Silversmithe/motor-controller-modules/README.md

# motor-controller-modules

A repository to store all projects involving motor control modules, which can be used in various other projects.

## File Descriptor Language:
- rt: realtime
- hp: high-precision
