Silversmithe/motor-controller-modules/single_quad_rt_hp/hardware/README.md

Motor Controller Board
======================================

### Version B1 (HULA) v0.2

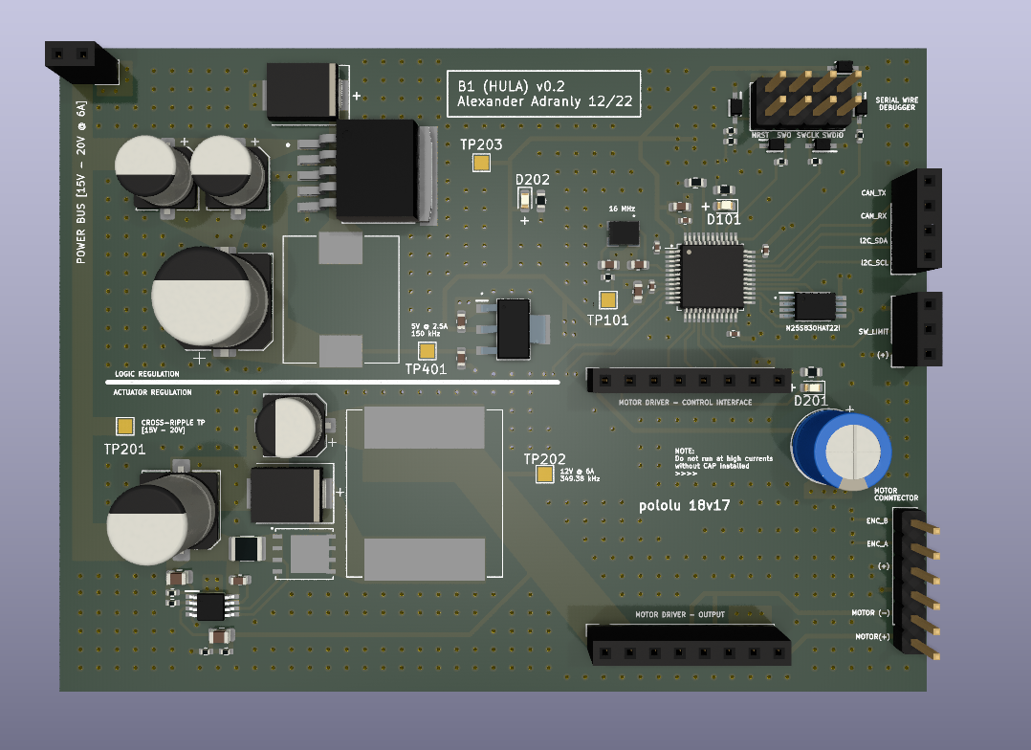
[picture p1: single_quad_rt_hp/hardware/images/motor_controller_v0_2.png]
B1 (HULA) v0.2
