Silversmithe/motor-controller-modules/single_quad_rt_hp/hardware/resources/lm2596-5_design.pdf

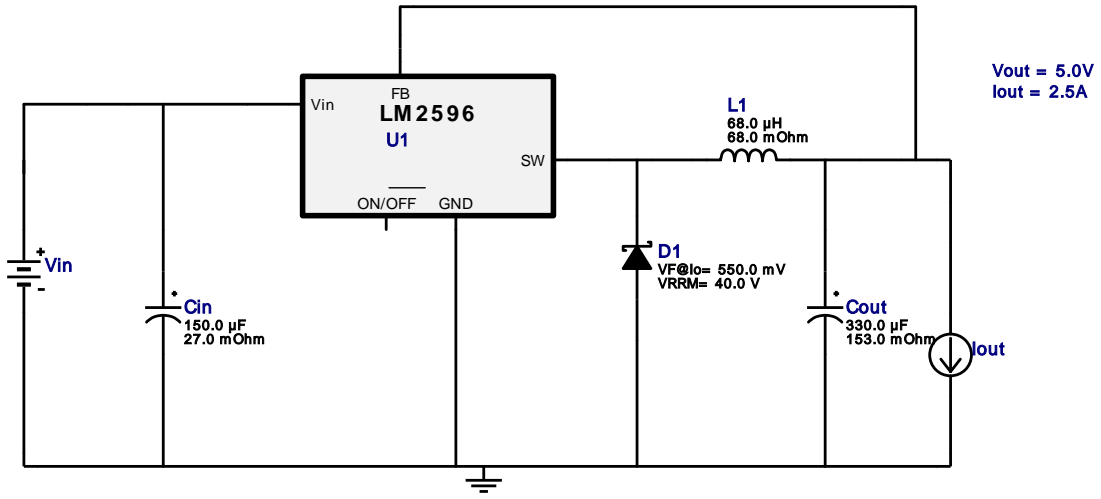
[picture p2: figure]
Cin 150.0 µF 27.0 m Ohm; Cout 330.0 µF 153.0 m Ohm; D1 VF@Io= 550.0 m V VRRM= 40.0 V; L1 68.0 µH 68.0 m Ohm; LM 2 5 9 6 Vin; ON/OFF; GND; Vout = 5.0V Iout = 2.5A; Vin; Iout

Copyright © 2022, Texas Instruments Incorporated | 1 | ti.com/webench

WEBENCH®
Design Report LM2596SX-5.0/NOPB : LM2596SX-5.0/ NOPB 15V-20V to 5.00V @ 2.5A November 18, 2022 22:43:04 GMT-06:00

## WEBENCH ® Design Report

Design : 3 LM2596SX-5.0/NOPB
LM2596SX-5.0/NOPB 15V-20V to 5.00V @ 2.5A

VinMin = 15.0V
VinMax = 20.0V
Vout = 5.0V
Iout = 2.5A

Device = LM2596SX-5.0/NOPB Topology = Buck
Created = 2022-11-18 22:30:03.629 BOM Cost = $6.35
BOM Count = 6
Total Pd = 2.56W

## Electrical BOM

Name | Manufacturer | Part Number | Properties | Qty Price | Footprint
Cf | Samsung Electro- Mechanics | CL21C332JBFNNNE (http://www.samsungsem.com/servlet/FileDownload?type%3Dspec%26file%3DCL21C332JBFNNNE.pdf) Series= C0G/NP0 | Cap= 3.3 nF VDC= 50.0 V IRMS= 0.0 A
1 | $0.04
| | | | | 0805 7 mm²
Cin | Panasonic | EEHZA1V151P Series= ZA | Cap= 150.0 uF ESR= 27.0 mOhm VDC= 35.0 V IRMS= 2.3 A
1 | $1.31

SM_RADIAL_8MM 113 mm²
Cout | Panasonic | EEV-FK2A331M (http://www.panasonic.com/industrial/components/pdf/smt%5Faec%5F050505.pdf) Series= FK

Cap= 330.0 uF
ESR= 153.0 mOhm
VDC= 100.0 V
IRMS= 917.0 mA

1 $1.60

SM_RADIAL_K16 483 mm²
D1 | Diodes Inc. | B540C-13-F (http://www.diodes.com/datasheets/ds13012.pdf) | VF@Io= 550.0 mV VRRM= 40.0 V
1 | $0.19

SMC 83 mm²
L1 | Coilcraft | MSS1210-683MEB (http://www.coilcraft.com/pdfs/mss1210.pdf) | L= 68.0 µH 68.0 mOhm
1 | $0.81

MSS1210 204 mm²

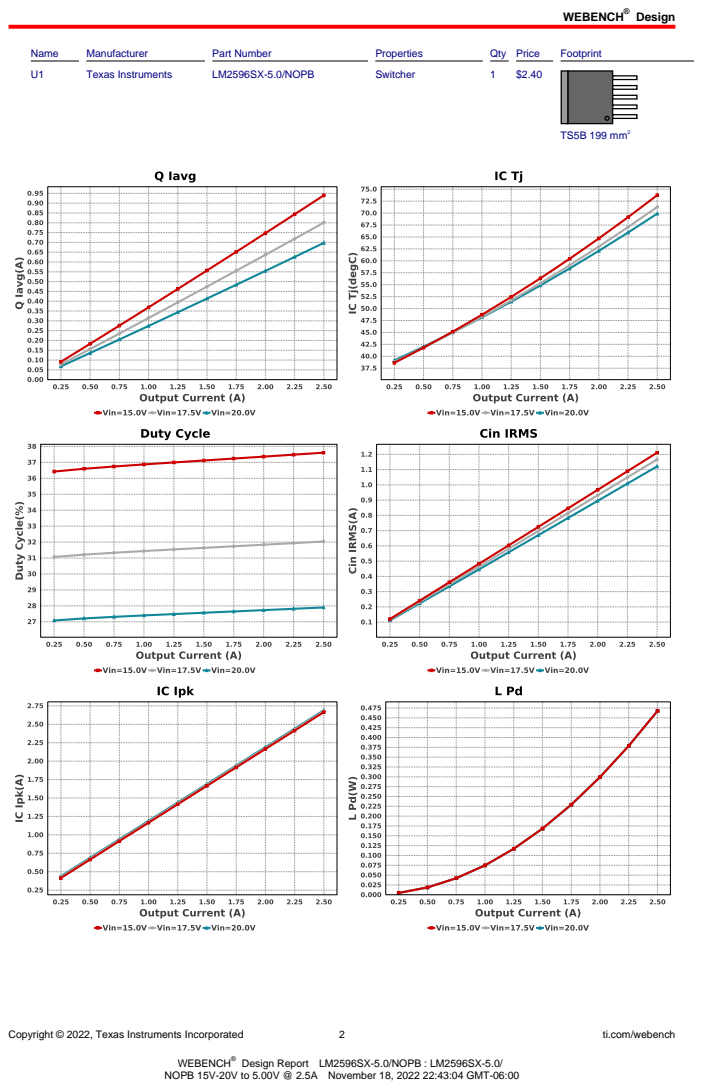
[picture p3: page 2]
Design; Copyright © 2022, Texas Instruments Incorporated; ti.com/webench; Name; Manufacturer; Part Number; Properties; Qty Price; Footprint; Texas Instruments; LM2596SX-5.0/NOPB; Switcher; TS5B 199 mm²

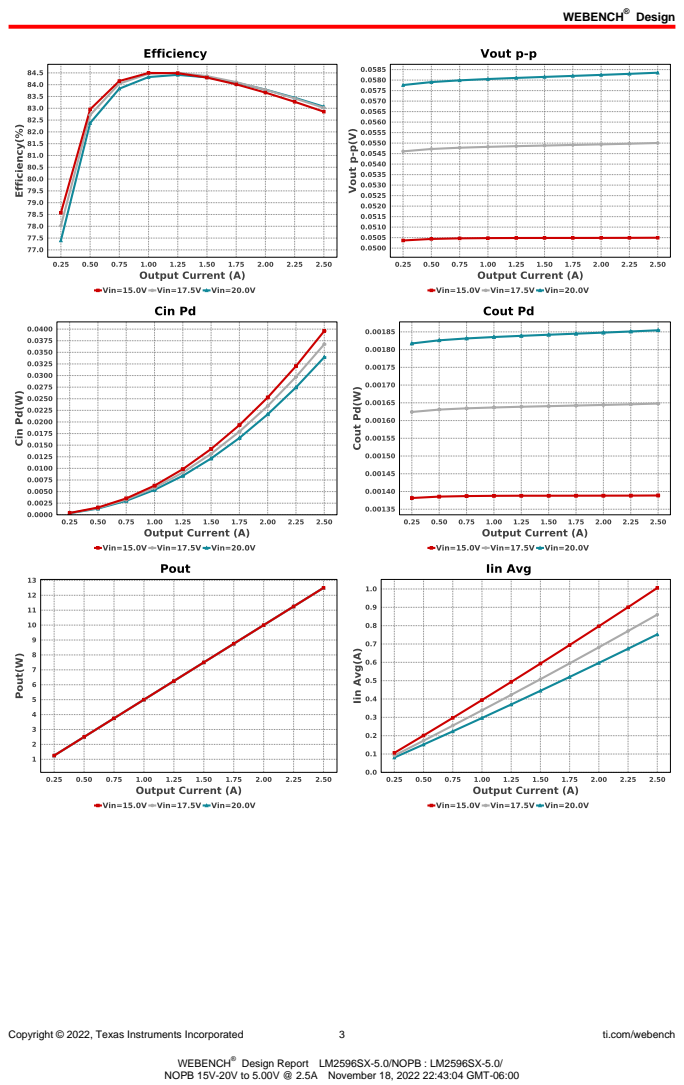
[picture p4: page 3]
Copyright © 2022, Texas Instruments Incorporated; ti.com/webench

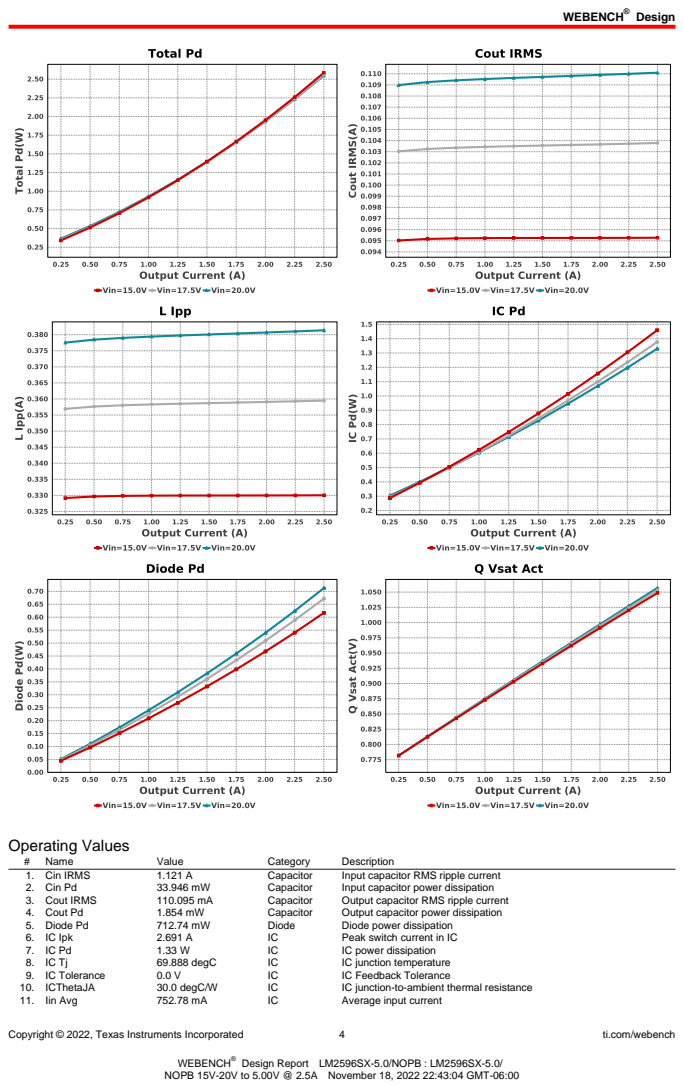
[picture p5: page 4]
Copyright © 2022, Texas Instruments Incorporated; ti.com/webench; Operating Values; Name; Value; Category; Description; 1. Cin IRMS; Capacitor; Input capacitor RMS ripple current; 2. Cin Pd; Input capacitor power dissipation; 3. Cout IRMS; Output capacitor RMS ripple current; 4. Cout Pd; Output capacitor power dissipation; 5. Diode Pd; Diode; Diode power dissipation; 6. IC Ipk; Peak switch current in IC; IC power dissipation; 69.888 degC; IC junction temperature; 9. IC Tolerance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

Copyright © 2022, Texas Instruments Incorporated | 5 | ti.com/webench
# | Name | Value | Category | Description

12. L Ipp | 381.38 mA | Inductor | Peak-to-peak inductor ripple current
13. L Pd | 467.5 mW | Inductor | Inductor power dissipation
14. Q Iavg | 697.501 mA | Mosfet | Q Iavg
15. Cin Pd | 33.946 mW | Power | Input capacitor power dissipation
16. Cout Pd | 1.854 mW | Power | Output capacitor power dissipation
17. Diode Pd | 712.74 mW | Power | Diode power dissipation
18. IC Pd | 1.33 W | Power | IC power dissipation
19. L Pd | 467.5 mW | Power | Inductor power dissipation
20. Total Pd | 2.556 W | Power | Total Power Dissipation
21. BOM Count | 6 | System
| | | Information | Total Design BOM count
22. Duty Cycle | 27.9 % | System
| | | Information | Duty cycle
23. Efficiency | 83.025 % | System
| | | Information | Steady state efficiency
24. FootPrint | 1.09 k mm² | System
| | | Information | Total Foot Print Area of BOM components
25. Frequency | 150.0 kHz | System
| | | Information | Switching frequency
26. Iout | 2.5 A | System
| | | Information | Iout operating point
27. Mode | CCM | System
| | | Information | Conduction Mode
28. Pout | 12.5 W | System
| | | Information | Total output power
29. Total BOM | $6.35 | System
| | | Information | Total BOM Cost
30. Vin | 20.0 V | System
| | | Information | Vin operating point
31. Vout p-p | 58.351 mV | System
| | | Information | Peak-to-peak output ripple voltage
32. Q Vsat Act | 1.057 V | Transistor | Q Vsat

## Design Inputs

Name | Value | Description
Iout | 2.5 | Maximum Output Current
VinMax | 20.0 | Maximum input voltage
VinMin | 15.0 | Minimum input voltage
Vout | 5.0 | Output Voltage
| base_pn | | LM2596 | Base Product Number
source | DC | Input Source Type
Ta | 30.0 | Ambient temperature


Copyright © 2022, Texas Instruments Incorporated | 6 | ti.com/webench

## Assembly

## Component Testing

Some published data on components in datasheets such as Capacitor ESR and Inductor DC resistance is based on conservative values that will guarantee that the components always exceed the specification. For design purposes it is usually better to work with typical values. Since this data is not always available it is a good practice to measure the Capacitance and ESR values of Cin and Cout, and the inductance and DC resistance of L1 before assembly of the board. Any large discrepancies in values should be electrically simulated in WEBENCH to check for instabilities and thermally simulated in WebTHERM to make sure critical temperatures are not exceeded.

## Soldering Component to Board

If board assembly is done in house it is best to tack down one terminal of a component on the board then solder the other terminal. For surface mount parts with large tabs, such as the DPAK, the tab on the back of the package should be pre-tinned with solder, then tacked into place by one of the pins. To solder the tab town to the board place the iron down on the board while resting against the tab, heating both surfaces simultaneously. Apply light pressure to the top of the plastic case until the solder flows around the part and the part is flush with the PCB. If the solder is not flowing around the board you may need a higher wattage iron (generally 25W to 30W is enough).

## Initial Startup of Circuit

It is best to initially power up the board by setting the input supply voltage to the lowest operating input voltage 15.0V and set the input supply's current limit to zero. With the input supply off connect up the input supply to Vin and GND. Connect a digital volt meter and a load if needed to set the minimum Iout of the design from Vout and GND. Turn on the input supply and slowly turn up the current limit on the input supply.
If the voltage starts to rise on the input supply continue increasing the input supply current limit while watching the output voltage. If the current increases on the input supply, but the voltage remains near zero, then there may be a short or a component misplaced on the board. Power down the board and visually inspect for solder bridges and recheck the diode and capacitor polarities. Once the power supply circuit is operational then more extensive testing may include full load testing, transient load and line tests to compare with simulation results.

## Load Testing

The setup is the same as the initial startup, except that an additional digital voltmeter is connected between Vin and GND, a load is connected between Vout and GND and a current meter is connected in series between Vout and the load. The load must be able to handle at least rated output power + 50% ( 7.5 watts for this design). Ideally the load is supplied in the form of a variable load test unit. It can also be done in the form of suitably large power resistors. When using an oscilloscope to measure waveforms on the prototype board, the ground leads of the oscilloscope probes should be as short as possible and the area of the loop formed by the ground lead should be kept to a minimum. This will help reduce ground lead inductance and eliminate EMI noise that is not actually present in the circuit.

## Design Assistance

1. Master key : 554E87F380B10EF862A869D8392B4870[v1]
2. LM2596 Product Folder : http://www.ti.com/product/LM2596 : contains the data sheet and other resources.

Copyright © 2022, Texas Instruments Incorporated | 7 | ti.com/webench

Important Notice and Disclaimer

TI provides technical and reliability data (including datasheets), design resources (including reference designs), application or other design advice, web tools, safety information, and other resources AS IS and with all faults, and disclaims all warranties. These resources are intended for skilled developers designing with TI products. You are solely responsible for (1) selecting the appropriate TI products for your application, (2) designing, validating and testing your application, and (3) ensuring your application meets applicable standards, and any other safety, security, or other requirements.

These resources are subject to change without notice. TI grants you permission to use these resources only for development of an application that uses the TI products described in the resource. Other reproduction and display of these resources is prohibited. No license is granted to any other TI intellectual property right or to any third party intellectual property right. TI disclaims responsibility for, and you will fully indemnify TI and its representatives against, any claims, damages, costs, losses, and liabilities arising out of your use of these resources.

Providing these resources does not expand or otherwise alter TI's applicable Terms of Sale or other applicable terms available either on ti.com or provided in conjunction with TI products.
