Silversmithe/motor-controller-modules/single_quad_rt_hp/hardware/images/motor_controller_v0_1.png

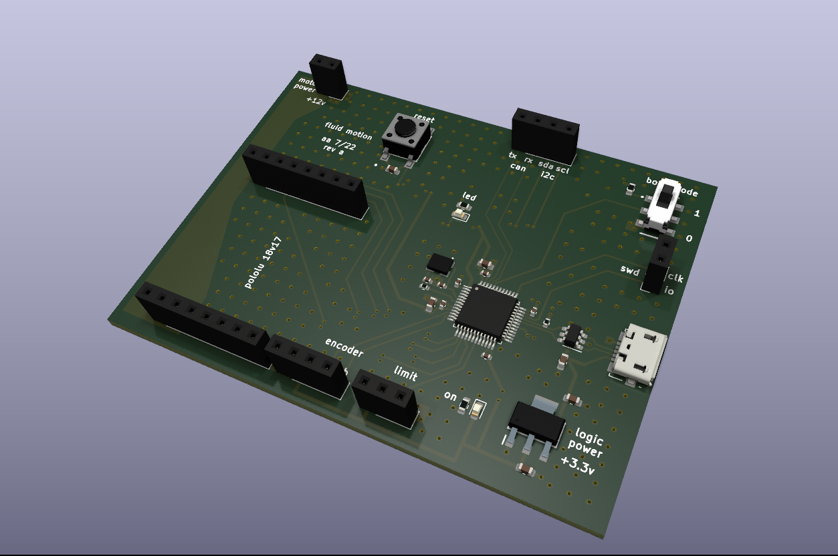
single_quad_rt_hp/hardware/images/motor_controller_v0_1.png
