Silversmithe/motor-controller-modules/single_quad_rt_hp/hardware/testing.xlsx

Sheet: v0.1
No. | Features |  | Does it work? | Hardware Hacking Required? | Notes
1 | Power Regulation
1.1 |  | 3.3V Regluator (Logic) | Y | N | Powered through power supply / USB, and in both scenarios the power LED turns on. The microcontroller can also sucessfully execute code.
1.2 |  | 12V Regulated Input (Actuator) | N/A | N | These are just female headers
2 | Microcontroller (STM32F302)
2.1 |  | Bypass Capacitors | Y | N | Manually checked all capacitors with a probe to ensure they all are carrying 3.3V
2.2 |  | HSE Clock | N | N/A | CPU Hardware Guide - Section 2.1 HSERDY flag in RCC_CR Flag determines if the clock is stable, and this must be set at startup. Check this flag to confirm if HSE is actually working correctly.
2.3 |  | Serial Wire Debug | Y | Y | Successfully can program the micro with STLINK. Had to use pins from other parts of the board to get STLINK to work correctly. PRINTF does NOT work! Notes: provide all necessary pins for STLINK (MCU VDD, GND, NRST, SWCLK, SWDIO). Provide SWO in order to be able to use tracing & printf
2.4 |  | Reset Button | Y | N | Notes: attach this to SWD in the second iteration of this board. Or maybe do both?
2.5 |  | BOOT0 Switch Select | N | N | Wired incorrectly, signal is unable to be pulled high. Pull-down resistor is incorrectly placed. Notes: Potentially just keep BOOT0 pulled low, because we don’t need to program via USB. Can potentially remove this circuit.
3 | Communication (COM)
3.1 |  | Universal Serial Bus (USB) 2.0 | N | N/A | USB Delivers power, but actual communication to the host computer has not been possible yet Notes: remove in the next generation, with SWD USB may just be unecessary
3.2 |  | Controller Area Network (CAN) | N/A | N/A
3.3 |  | I2C | Y | N/A | Hooked up to an arduino (master). Very easy to set up.
4 | Status Signals (STAT)
4.1 |  | Power LED | Y | N | Turns on when power is supplied to the board & light is bright.
4.2 |  | Status LED (LED_STAT) | Y | N | Turns on when pin set high by microcontroller
5 | Control/Feedback Signals (CTRL)
5.1 |  | Limit Switch (SW_LIMIT) | Y | N | Works as expected. Wired button with resistor to the limit switch to test.
5.2 |  | Motor - Direction | Y | Y | Notes: Incorrectly routed
5.3 |  | Motor - Speed (PWM) | Y | Y | Notes: Incorrectly routed
5.4 |  | Motor - Sleep | Y | Y | Notes: Incorrectly routed
5.5 |  | Motor - Fault | Y | Y | Notes: Incorrectly routed
5.6 |  | Encoders A & B | Y | N/A | Counts up to 400 ticks from one full rotation. 6.25 (gear ratio) * 64 (ticks per shaft revolution) = 400 ticks. Verify that clock does not revert to internal version for complete success. Notes:

Sheet: v0.2
No. | Features |  | Does it work? | Hardware Hacking Required? | Notes
1 | Power Regulation
1.1 |  | 3.3V Regulator Logic | N | N/A | [15V - 20V] -> 5V (Switching Regulator) -> 3.3V (Linear Regulator) - switching regulator outputs only 0.4V, likely an issue with component selection
1.2 |  | 12V Regulator Actuator | N | N/A | [15V - 20V] -> 12V (Switching Regulator) - smokes at input capacitor, potentially a short. Sparks when trying to power using BUS test point. - this regulator is excessive, we can just remove this and rely on the power supply for the entire robot
2 | Microcontroller (STM32F302)
2.1 |  | Bypass Capacitors | N/A | N/A | Manually checked all capacitors with a probe to ensure they all are carrying 3.3V
2.2 |  | HSE Clock | N/A | N/A | CPU Hardware Guide - Section 2.1 HSERDY flag in RCC_CR Flag determines if the clock is stable, and this must be set at startup. Check this flag to confirm if HSE is actually working correctly.
2.3 |  | Serial Wire Debug | N/A | N/A
2.4 |  | BOOT0 Select | N/A | N/A
3 | Peripherals
3.1 |  | SRAM | N/A | N/A
4 | Communication (COM)
4.1 |  | Controller Area Network (CAN) | N/A | N/A
4.2 |  | I2C | N/A | N/A
5 | Status Signals (STAT)
5.1 |  | Logic Power LED | N/A | N/A
5.2 |  | Actuator Power LED | N/A | N/A
5.3 |  | LED STAT | N/A | N/A
6 | Control/Feedback Signals (CTRL)
6.1 |  | Limit Switch (SW_LIMIT) | N/A | N/A
6.2 |  | Motor - Direction | N/A | N/A
6.3 |  | Motor - Speed (PWM) | N/A | N/A
6.4 |  | Motor - Sleep | N/A | N/A
6.5 |  | Motor - Fault | N/A | N/A
6.6 |  | Encoders A & B | N/A | N/A
