Silversmithe/motor-controller-modules/single_quad_rt_hp/hardware/versions/motor_controller-v0_1/motor_controller_schematic.pdf

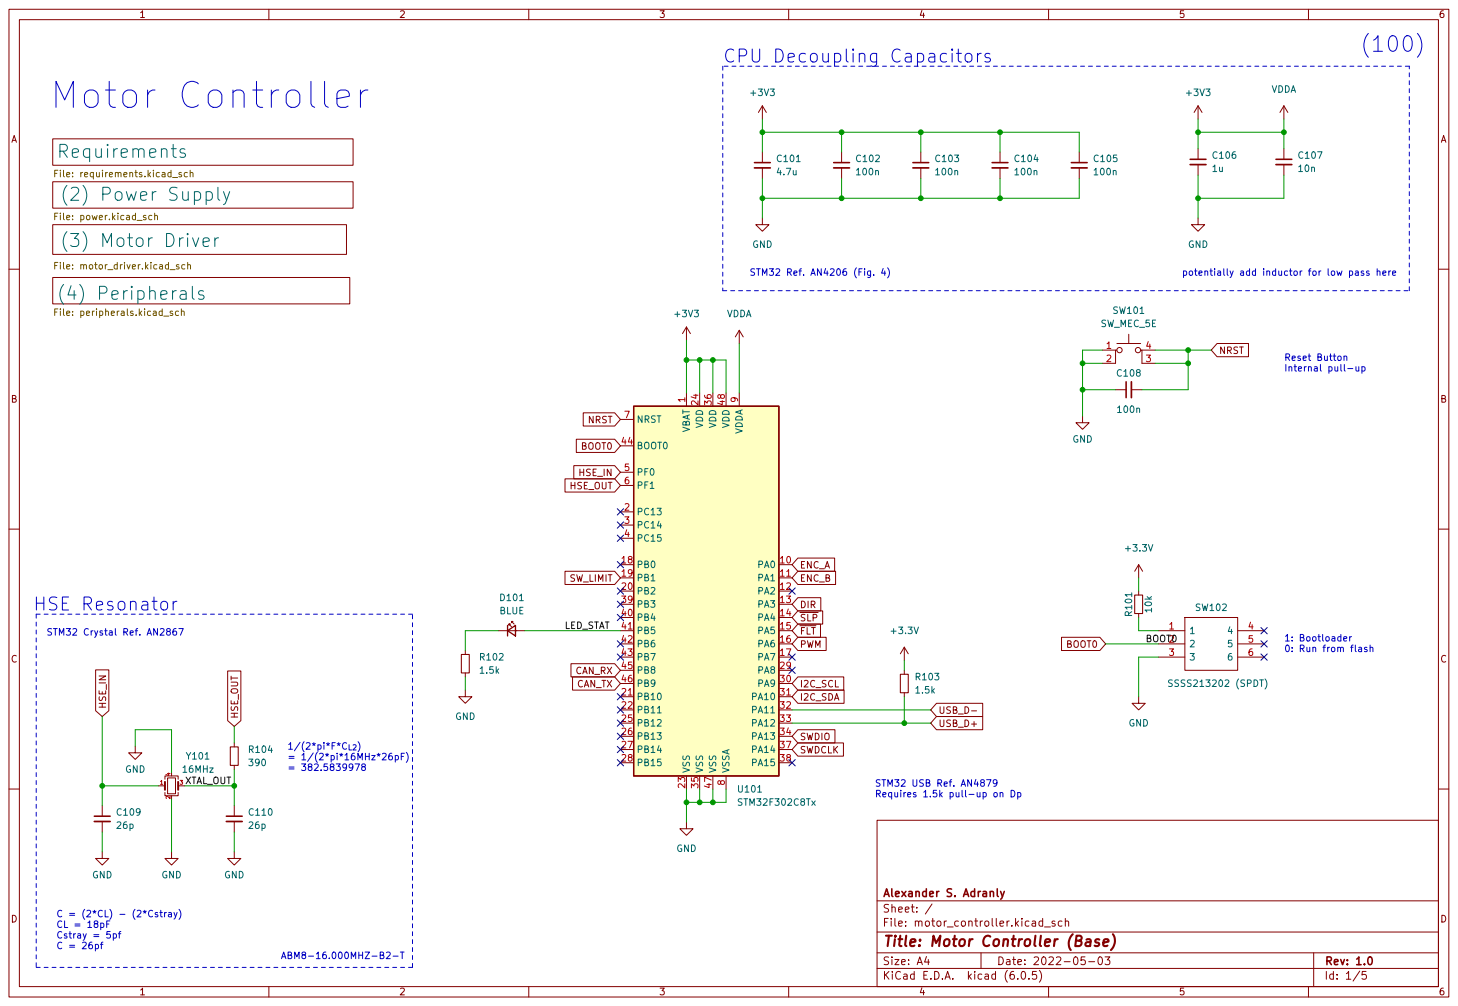
[picture p8: page 1]

1 PA0 10 PA1 11 PA2 12 PA3 13 PA4 14 PA5 15 PA6 16 PA7 17 PB0 18 PB1 19 PC13 2 PB2 20 PB10 21 PB11 22 VSS 23 VDD 24 PB12 25 PB13 26 PB14 27 PB15 28 PA8 29 PC14 3 PA9 30 PA10 31 PA11 32 PA12 33 PA13 34 VSS 35 VDD 36 PA14 37 PA15 38 PB3 39 PC15 4 PB4 40 PB5 41 PB6 42 PB7 43 BOOT0 44 PB8 45 PB9 46 VSS 47 VDD 48 PF0 5 PF1 6 NRST 7 VSSA

File: motor_controller.kicad_sch Sheet: / Alexander S. Adranly

Id: 1/5 Title: Motor Controller (Base)

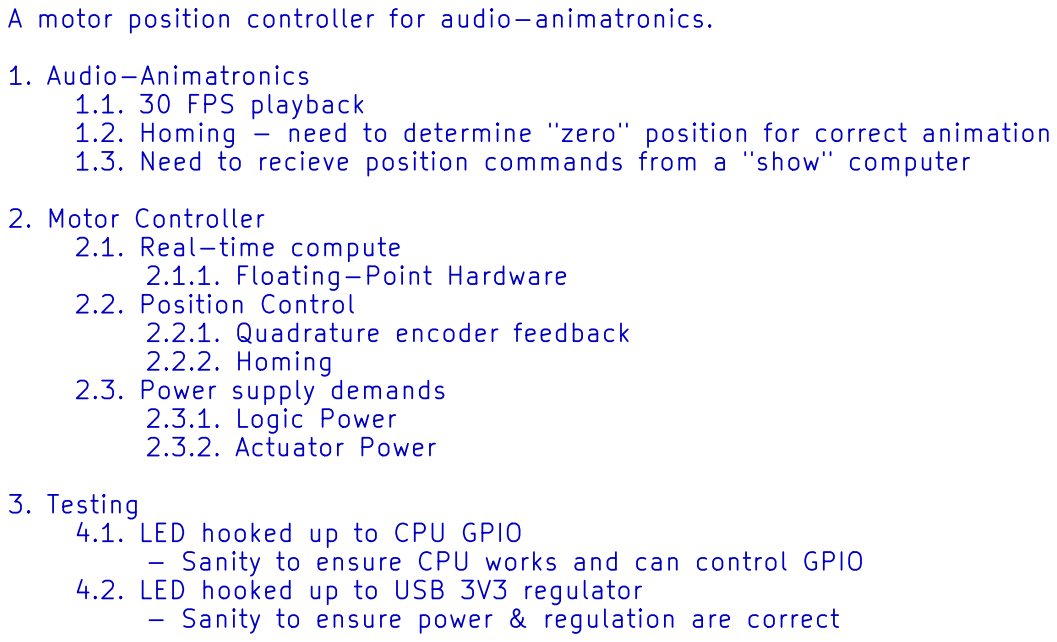
[picture p9: page 2]

A motor position controller for audio-animatronics. 1. Audio-Animatronics

1.1. 30 FPS playback
1.2. Homing - need to determine "zero" position for correct animation
1.3. Need to recieve position commands from a "show" computer 2. Motor Controller

2.1. Real-time compute
2.1.1. Floating-Point Hardware
2.2. Position Control 2.2.1. Quadrature encoder feedback

3. Testing
4.1. LED hooked up to CPU GPIO
- Sanity to ensure CPU works and can control GPIO
4.2. LED hooked up to USB 3V3 regulator
- Sanity to ensure power & regulation are correct

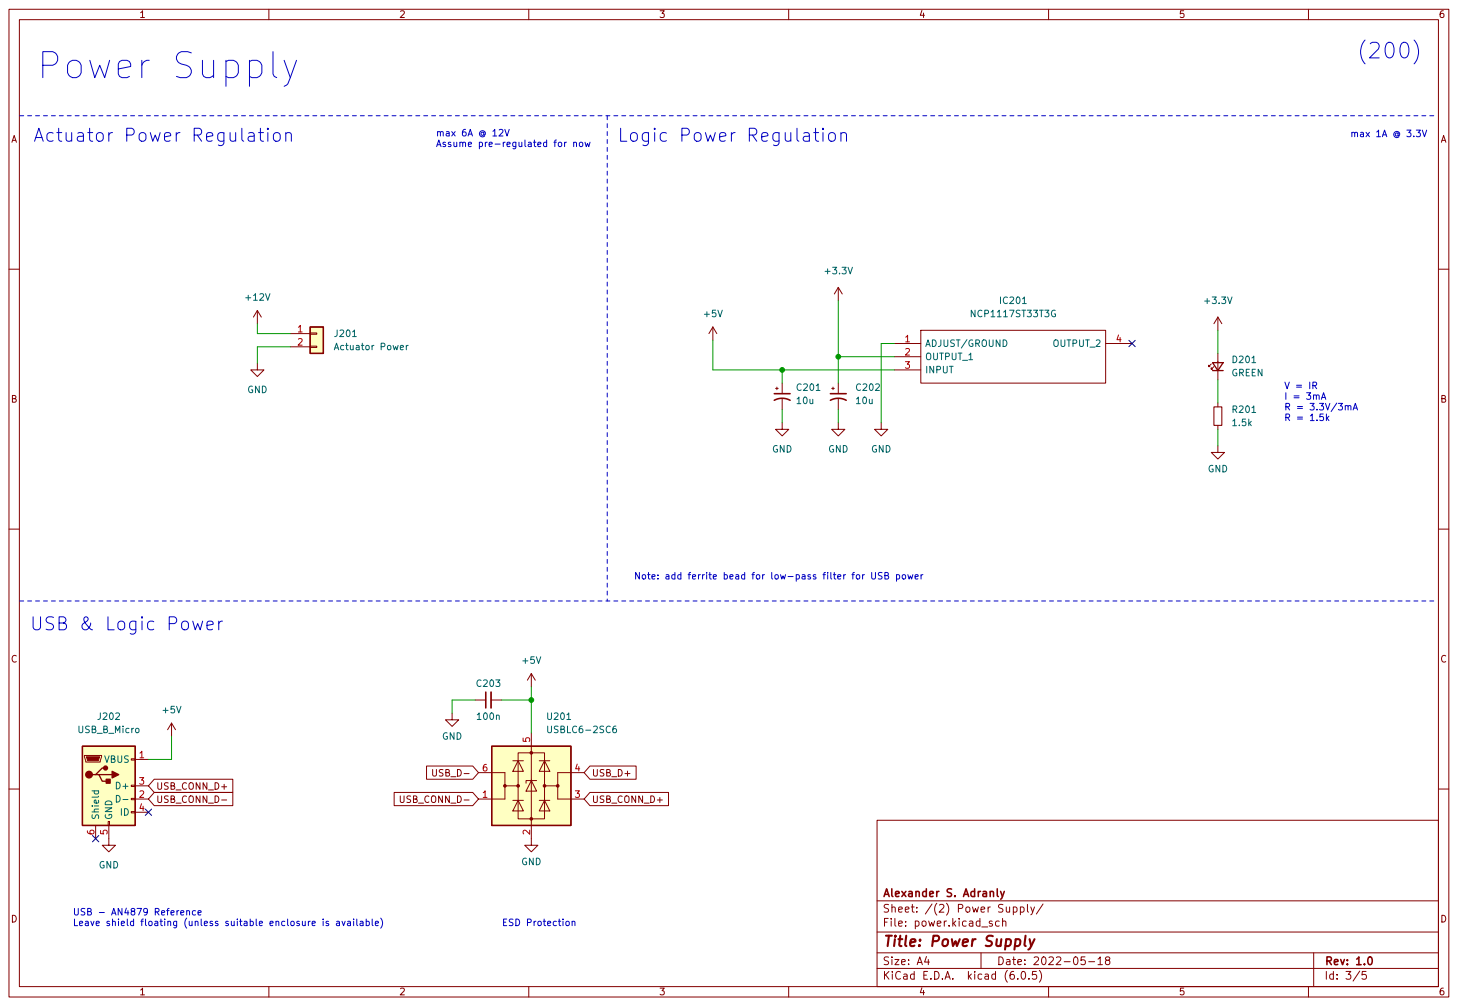
[picture p10: page 3]

(200) max 1A @ 3.3V USB & Logic Power USB - AN4879 Reference
Power Supply

max 6A @ 12V
Assume pre-regulated for now

Sheet: /(2) Power Supply/
File: power.kicad_sch
Id: 3/5 Title: Power Supply

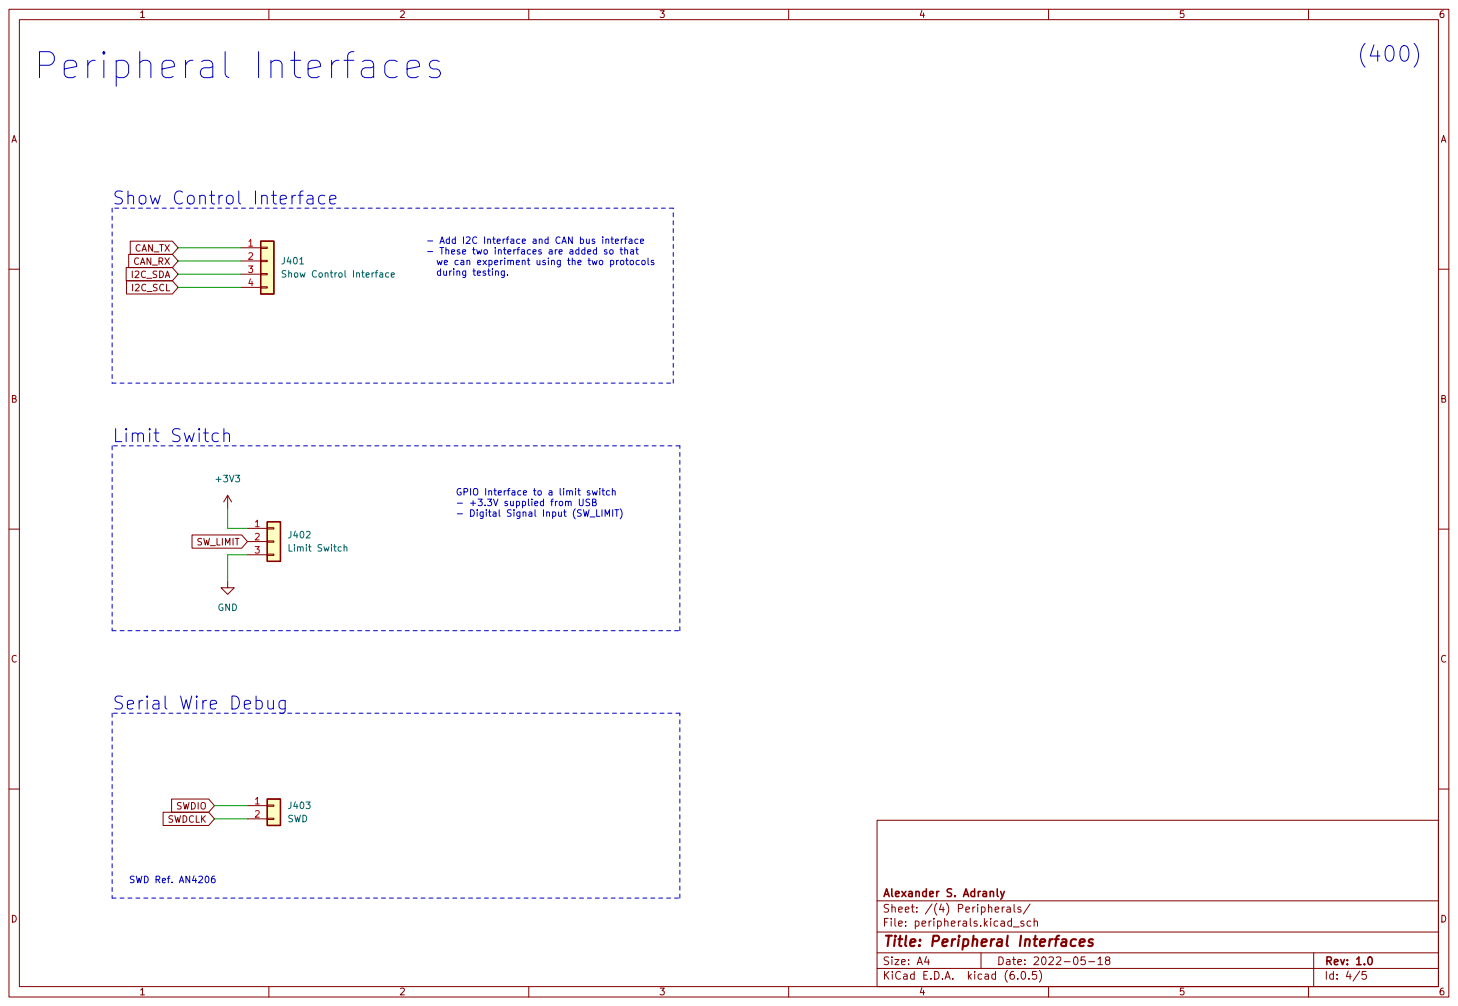
[picture p11: page 4]

- Add I2C Interface and CAN bus interface
- These two interfaces are added so that
we can experiment using the two protocols
during testing.

GPIO Interface to a limit switch
- +3.3V supplied from USB
- Digital Signal Input (SW_LIMIT)

Alexander S. Adranly
Sheet: /(4) Peripherals/
File: peripherals.kicad_sch
Id: 4/5 Title: Peripheral Interfaces

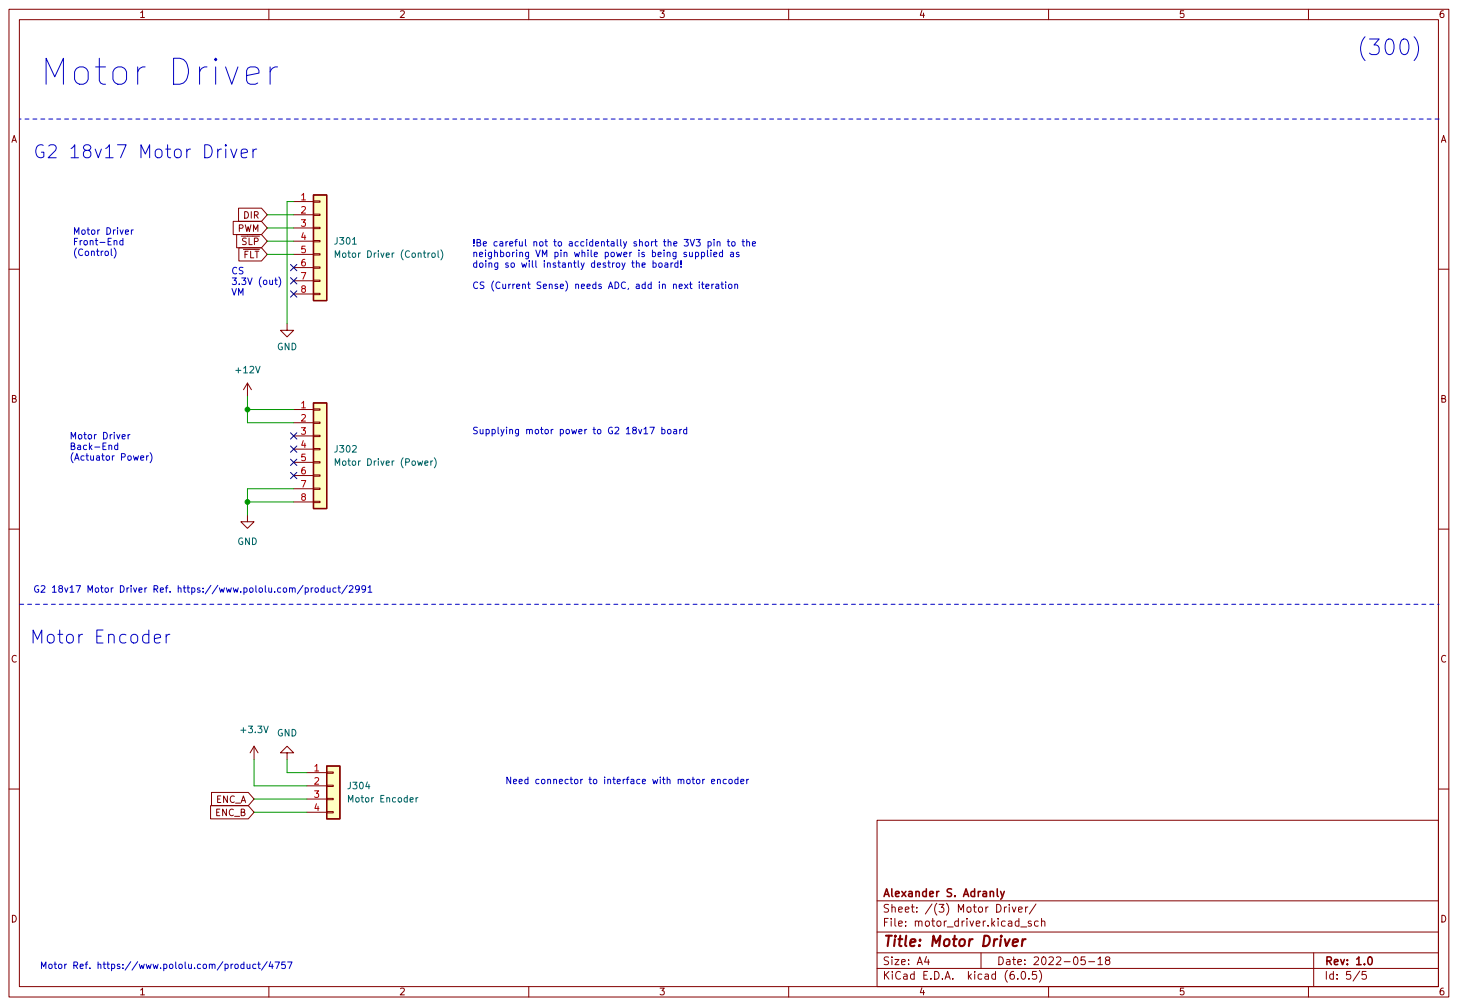
[picture p12: page 5]

Motor Driver Front-End (Control)

!Be careful not to accidentally short the 3V3 pin to the
neighboring VM pin while power is being supplied as
doing so will instantly destroy the board!

CS (Current Sense) needs ADC, add in next iteration

G2 18v17 Motor Driver Ref. https://www.pololu.com/product/2991 Motor Driver Back-End (Actuator Power)

Alexander S. Adranly
Sheet: /(3) Motor Driver/
File: motor_driver.kicad_sch
Id: 5/5 Title: Motor Driver

Motor Ref. https://www.pololu.com/product/4757
