Silversmithe/motor-controller-modules/single_quad_rt_hp/hardware/versions/motor_controller-v0_1/motor_controller_pcb.pdf

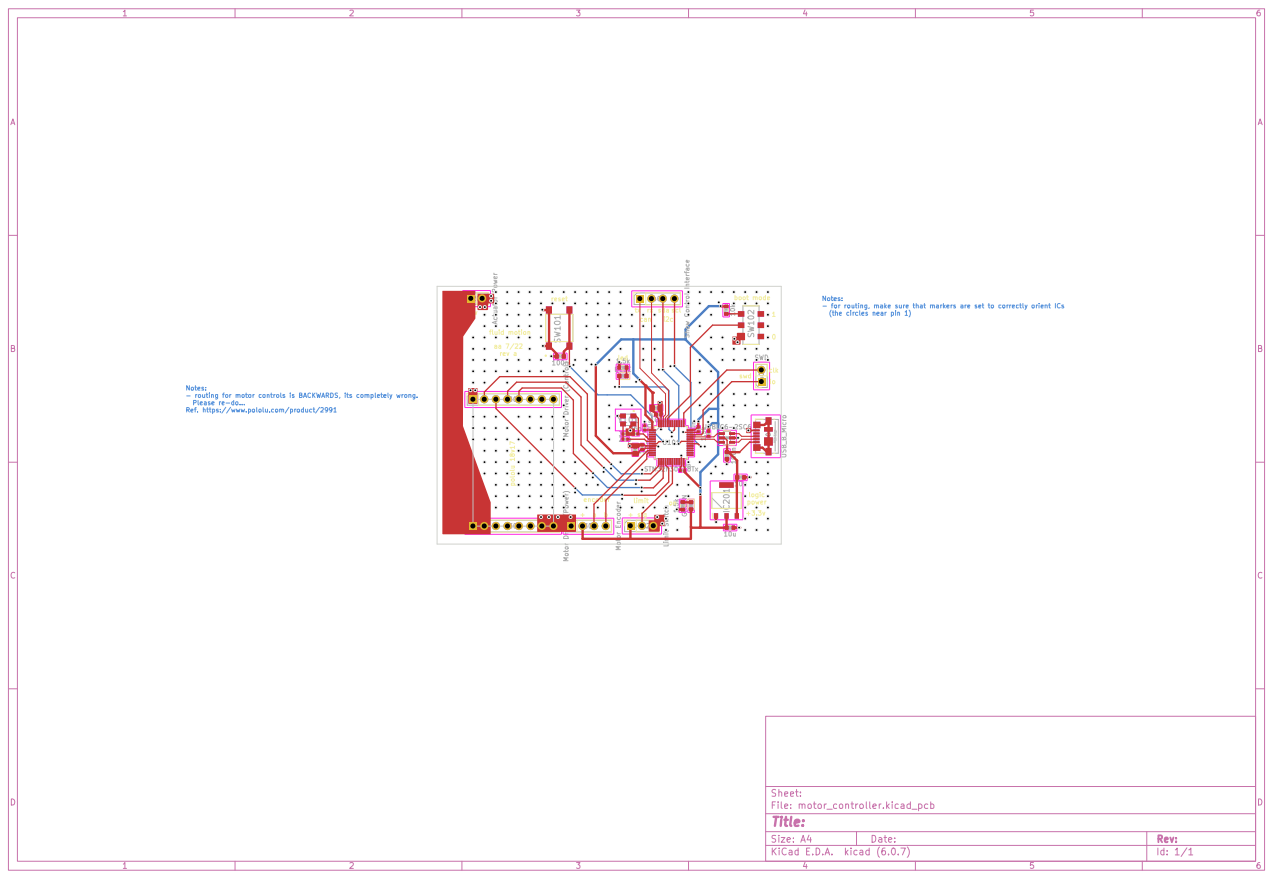
[picture p18: page 1]
