Silversmithe/motor-controller-modules/single_quad_rt_hp/hardware/motor_controller/actuator_regulator.kicad_sch

## KiCad design single_quad_rt_hp/hardware/motor_controller/actuator_regulator.kicad_sch (2023-01-30)

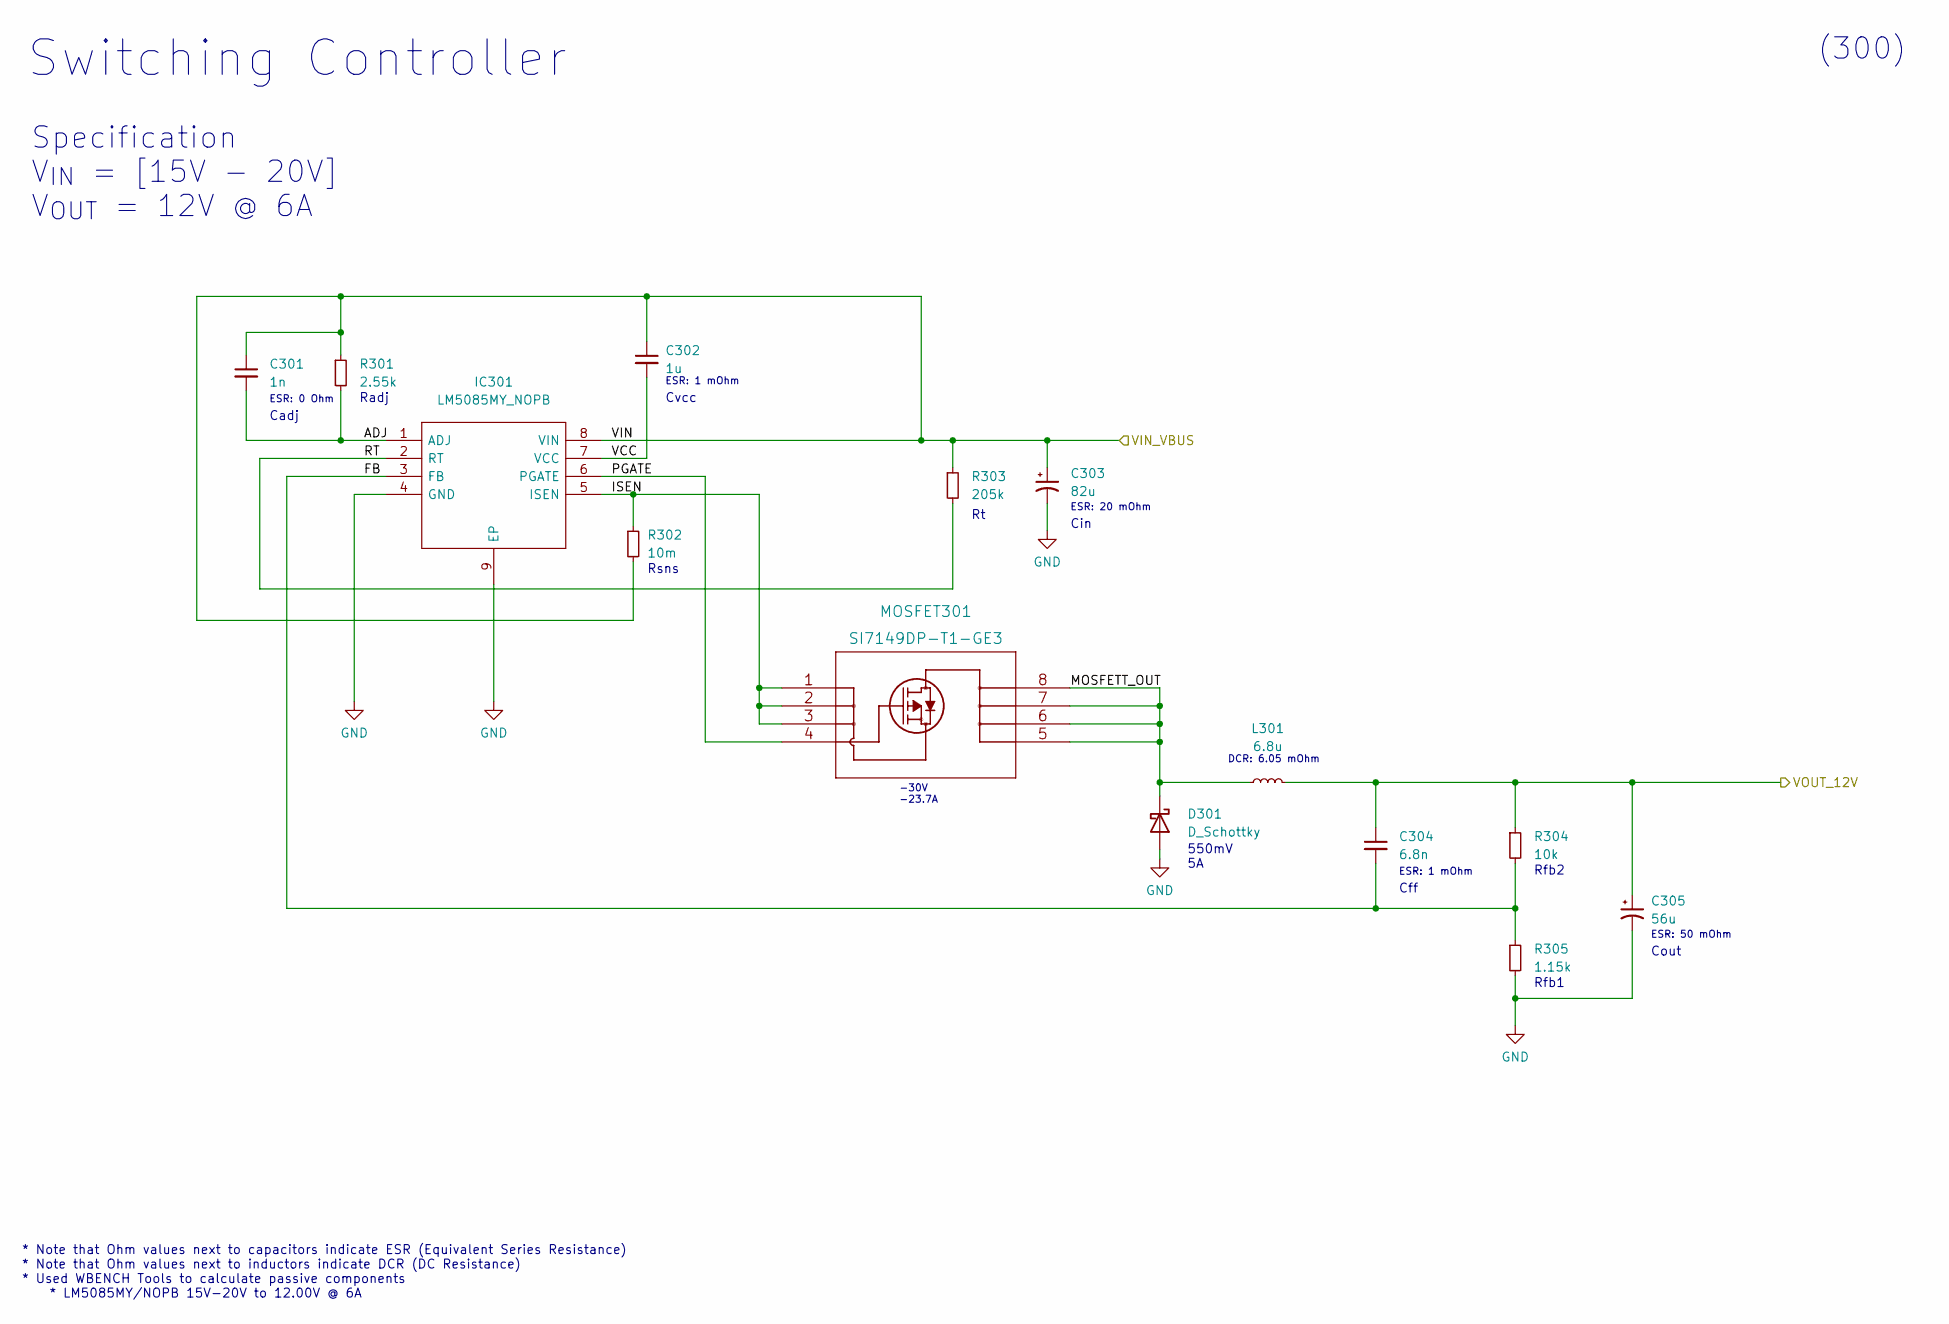
[picture p19: schematic actuator_regulator.kicad_sch]

Parts:
C301: 1n; C_0805_2012Metric; Manufacturer_Part_Number CL21C102JBCNNNC
C302: 1u; C_0603_1608Metric; Manufacturer_Part_Number EMK107B7105KA-T
C303: 82u; CP_Elec_8x11.9; Manufacturer_Part_Number 35SVPF82M
C304: 6.8n; C_0805_2012Metric; Manufacturer_Part_Number GRM2195C1H682JA01D
C305: 56u; CP_Elec_6.3x5.8; Manufacturer_Part_Number EEHZC1E560P
D301: D_Schottky; D_SMC; Manufacturer_Part_Number B540C-13-F
IC301: LM5085MY_NOPB; SOP65P490X109-9N; Mouser Part Number 926-LM5085MY/NOPB
L301: 6.8u; YSPIA1770-6R8M; Manufacturer_Part_Number YSPIA1770-6R8M
MOSFET301: SI7149DP-T1-GE3; Manufacturer_Part_Number SI7149DP-T1-GE3
R301: 2.55k; R_0402_1005Metric; Manufacturer_Part_Number TC0250B2551TCC
R302: 10m; R_1210_3225Metric; Manufacturer_Part_Number 1210W2F100MT5E
R303: 205k; R_0402_1005Metric; Manufacturer_Part_Number AC0402FR-07205KL
R304: 10k; R_0402_1005Metric; Manufacturer_Part_Number 0402WGF1002TCE
R305: 1.15k; R_0402_1005Metric; Manufacturer_Part_Number RTT021151FTH

Connections:
ADJ: C301.2, IC301.1 (ADJ), R301.2
FB: C304.2, IC301.3 (FB), R304.2, R305.1
GND: C303.2, C305.2, D301.2 (A), IC301.4 (GND), IC301.9 (EP), R305.2
ISEN: IC301.5 (ISEN), MOSFET301.1, MOSFET301.2, MOSFET301.3, R302.1
MOSFETT_OUT: D301.1 (K), L301.1, MOSFET301.5, MOSFET301.6, MOSFET301.7, MOSFET301.8
PGATE: IC301.6 (PGATE), MOSFET301.4
RT: IC301.2 (RT), R303.2
VCC: C302.2, IC301.7 (VCC)
VIN: C301.1, C302.1, C303.1, IC301.8 (VIN), R301.1, R302.2, R303.1
VOUT_12V: C304.1, C305.1, L301.2, R304.1

Notes on the sheet:
DCR: 6.05 mOhm
Rfb1
Cin
Rsns
-30V -23.7A
Cadj
Rfb2
ESR: 20 mOhm
ESR: 0 Ohm
(300)
Specification V_{IN} = [15V - 20V] V_{OUT} = 12V @ 6A
Cff
Radj
Cvcc
* Note that Ohm values next to capacitors indicate ESR (Equivalent Series Resistance) * Note that Ohm values next to inductors indicate DCR (DC Resistance) * Used WBENCH Tools to calculate passive components * LM5085MY/NOPB 15V-20V to 12.00V @ 6A
ESR: 50 mOhm
ESR: 1 mOhm
Cout
Switching Controller
550mV 5A
