Silversmithe/motor-controller-modules/single_quad_rt_hp/hardware/motor_controller/bus_regulator.kicad_sch

## KiCad design single_quad_rt_hp/hardware/motor_controller/bus_regulator.kicad_sch (2023-01-30)

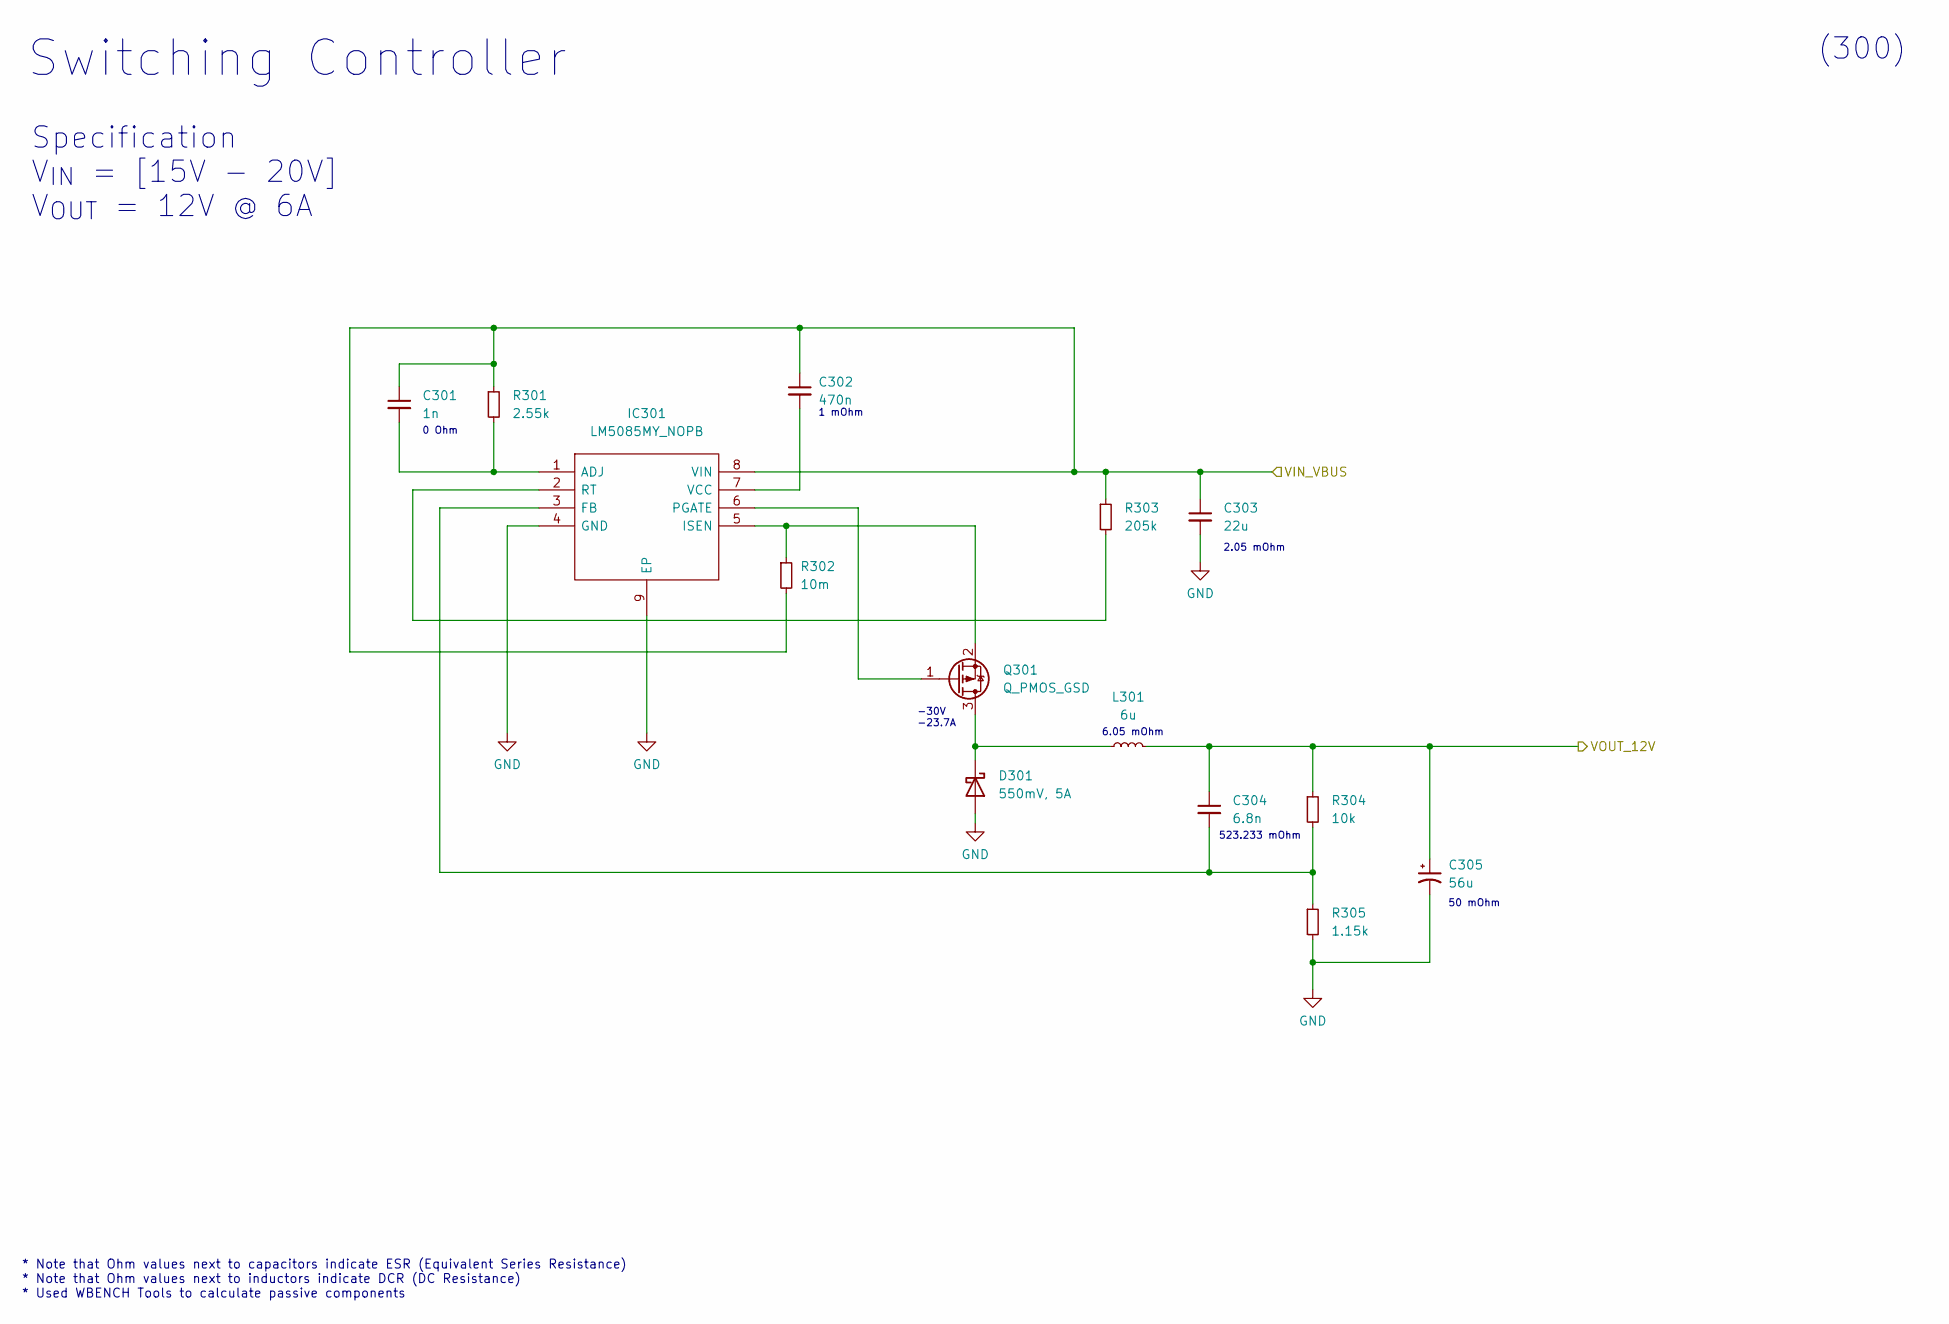
[picture p20: schematic bus_regulator.kicad_sch]

Parts:
C301: 1n
C302: 470n
C303: 22u
C304: 6.8n
C305: 56u
D301: 550mV, 5A
IC301: LM5085MY_NOPB; SOP65P490X109-9N; Mouser Part Number 926-LM5085MY/NOPB
L301: 6u
Q301: Q_PMOS_GSD
R301: 2.55k
R302: 10m
R303: 205k
R304: 10k
R305: 1.15k

Connections:
GND: C303.2, C305.2, D301.2 (A), IC301.4 (GND), IC301.9 (EP), R305.2
unnamed: C301.2, IC301.1 (ADJ), R301.2
unnamed: C302.2, IC301.7 (VCC)
unnamed: C304.2, IC301.3 (FB), R304.2, R305.1
unnamed: D301.1 (K), L301.1, Q301.3 (D)
unnamed: IC301.2 (RT), R303.2
unnamed: IC301.5 (ISEN), Q301.2 (S), R302.1
unnamed: IC301.6 (PGATE), Q301.1 (G)
VIN_VBUS: C301.1, C302.1, C303.1, IC301.8 (VIN), R301.1, R302.2, R303.1
VOUT_12V: C304.1, C305.1, L301.2, R304.1

Notes on the sheet:
6.05 mOhm
-30V -23.7A
2.05 mOhm
0 Ohm
(300)
Specification V_{IN} = [15V - 20V] V_{OUT} = 12V @ 6A
* Note that Ohm values next to capacitors indicate ESR (Equivalent Series Resistance) * Note that Ohm values next to inductors indicate DCR (DC Resistance) * Used WBENCH Tools to calculate passive components
50 mOhm
1 mOhm
523.233 mOhm
Switching Controller
