Silversmithe/motor-controller-modules/single_quad_rt_hp/hardware/motor_controller/logic_regulator.kicad_sch

## KiCad design single_quad_rt_hp/hardware/motor_controller/logic_regulator.kicad_sch (2023-04-17)

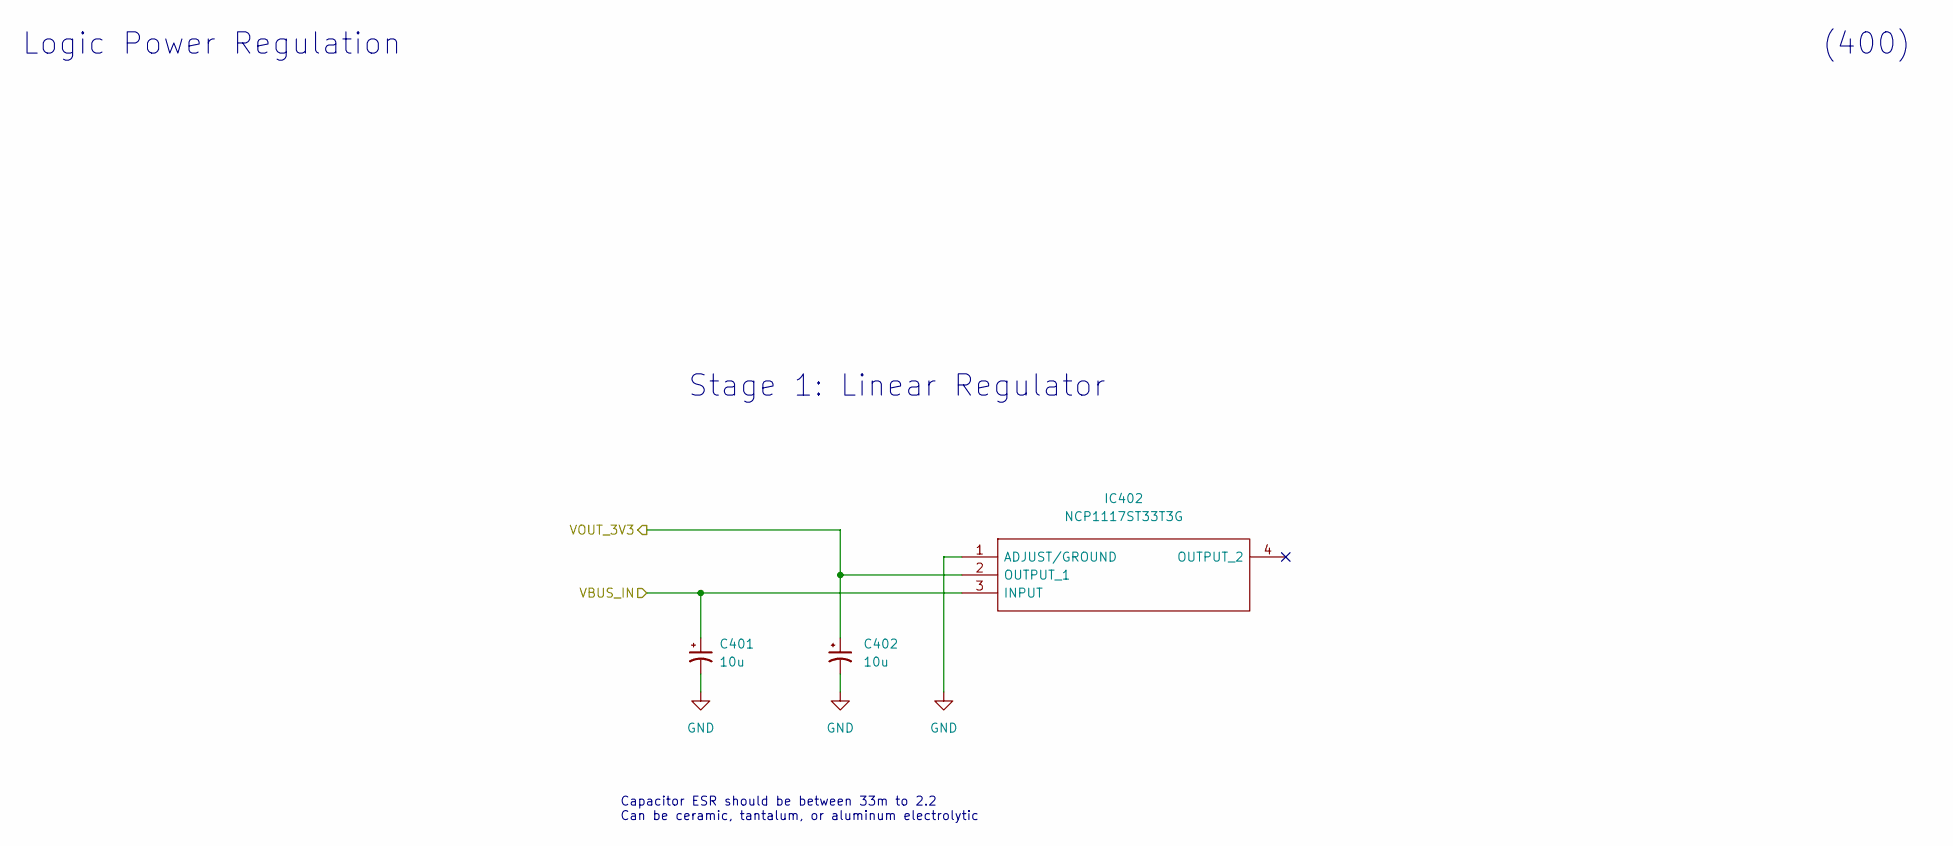
[picture p21: schematic logic_regulator.kicad_sch]

Parts:
C401, C402: 10u; C_0603_1608Metric; Manufacturer_Part_Number CL10A106KP8NNNC
IC402: NCP1117ST33T3G; SOT230P700X180-4N; Mouser Part Number 863-NCP1117ST33T3G

Connections:
GND: C401.2, C402.2, IC402.1 (ADJUST/GROUND)
VBUS_IN: C401.1, IC402.3 (INPUT)
VOUT_3V3: C402.1, IC402.2 (OUTPUT_1)

Notes on the sheet:
(400)
Stage 1: Linear Regulator
Capacitor ESR should be between 33m to 2.2 Can be ceramic, tantalum, or aluminum electrolytic
Logic Power Regulation
