Silversmithe/motor-controller-modules/single_quad_rt_hp/hardware/motor_controller/motor_controller.kicad_sch

## KiCad design single_quad_rt_hp/hardware/motor_controller/motor_controller.kicad_sch (2023-04-17)

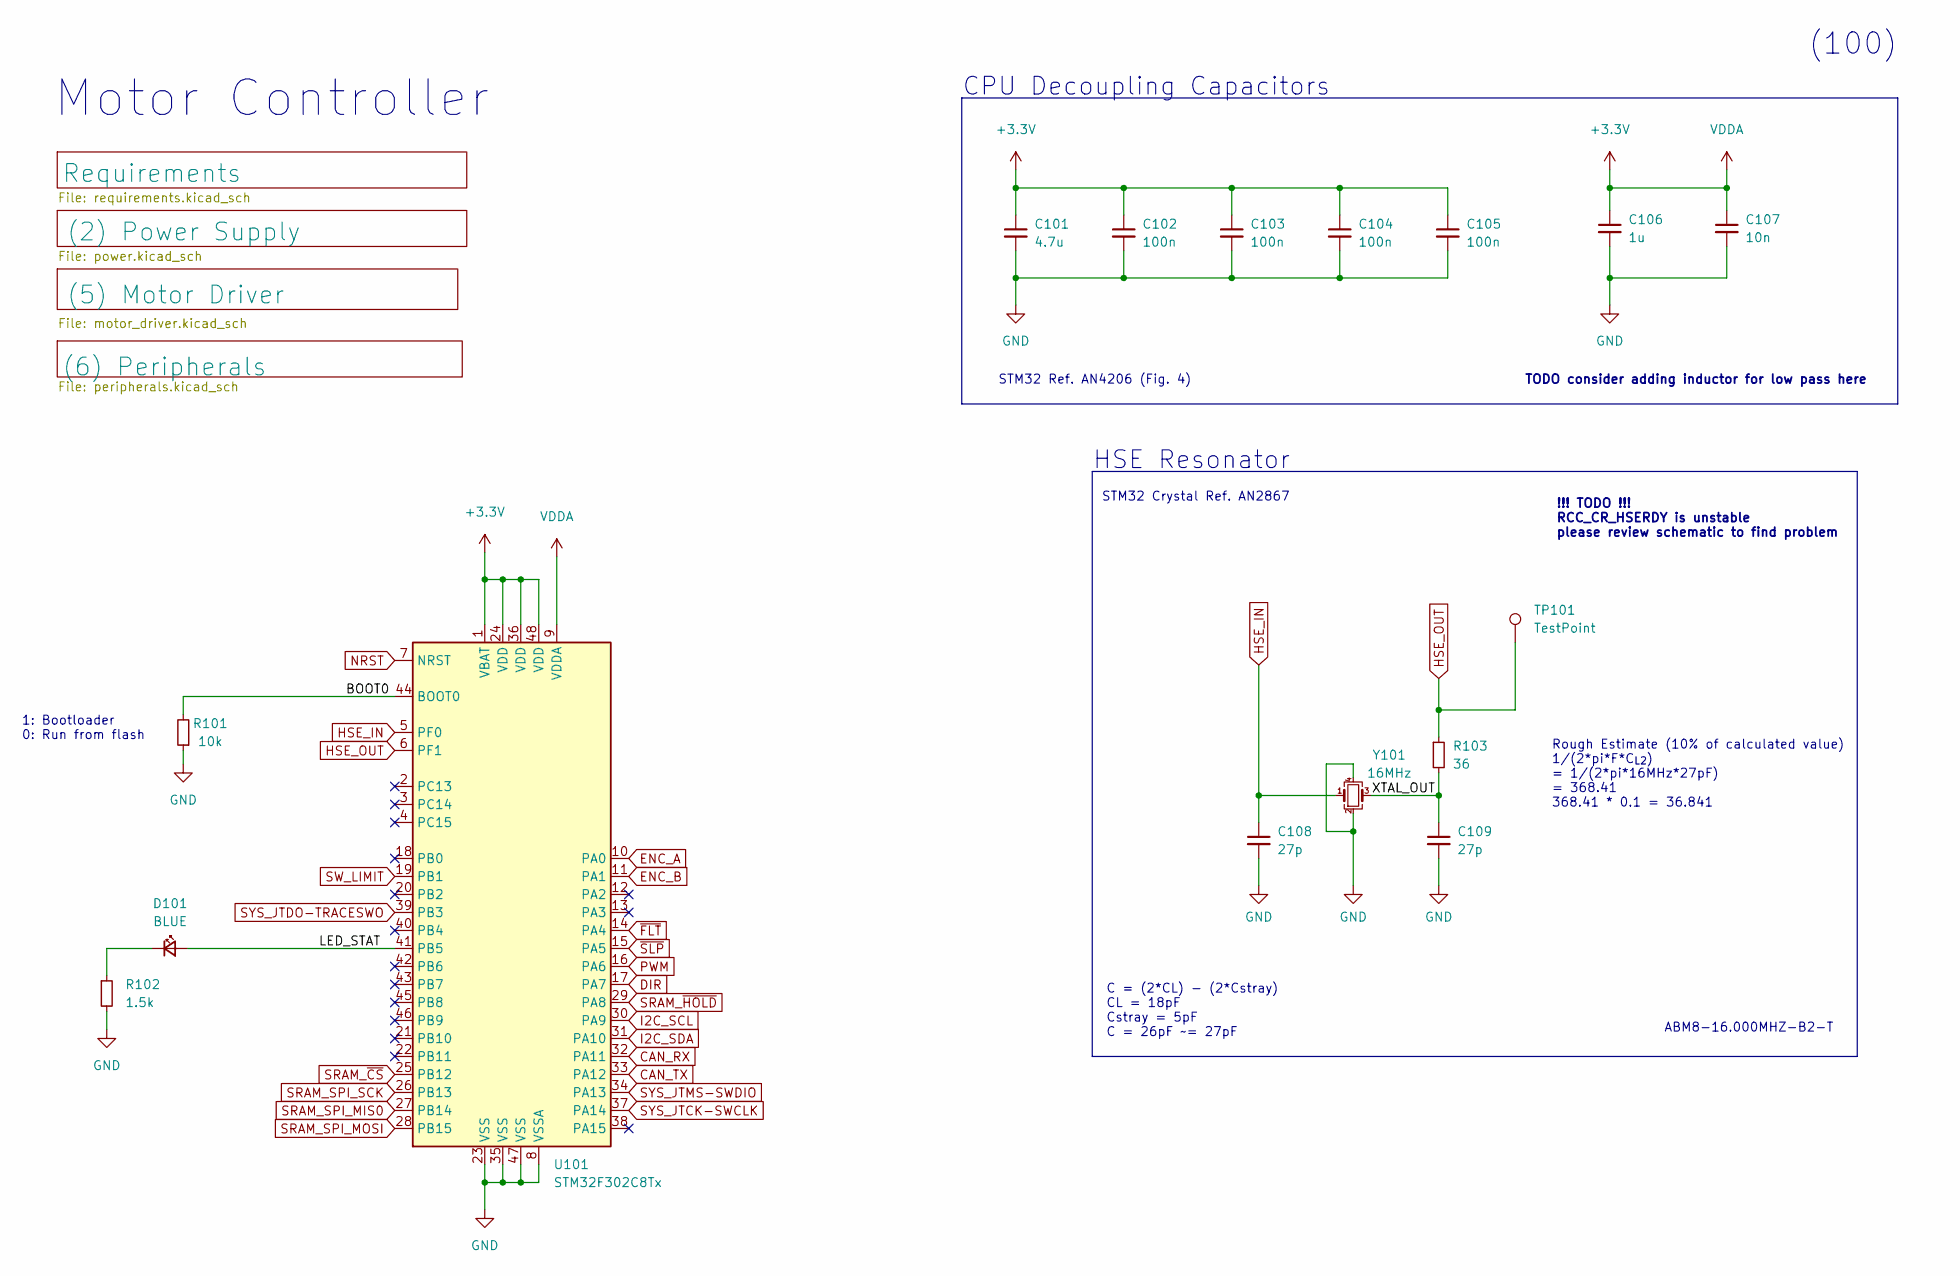
[picture p22: schematic motor_controller.kicad_sch]

Parts:
C101: 4.7u; C_0603_1608Metric; Manufacturer_Part_Number CL10A475KO8NNNC
C102, C103, C104, C105: 100n; C_0402_1005Metric; Manufacturer_Part_Number CL05B104KB54PNC
C106: 1u; C_0603_1608Metric; Manufacturer_Part_Number CL10A105KB8NNNC
C107: 10n; C_0402_1005Metric; Manufacturer_Part_Number CL05B103KB5NNNC
C108, C109: 27p; C_0603_1608Metric; Manufacturer_Part_Number GRM1885C1H270FA01D
D101: BLUE; LED_0603_1608Metric; Manufacturer_Part_Number 19-217/BHC-ZL1M2RY/3T
R101: 10k; R_0603_1608Metric; Manufacturer_Part_Number 0603WAF1002T5E
R102: 1.5k; R_0603_1608Metric; Manufacturer_Part_Number 0603WAF1501T5E
R103: 36; R_0402_1005Metric; Manufacturer_Part_Number RTT0236R0FTH
TP101: TestPoint; TestPoint_Pad_1.5x1.5mm
U101: STM32F302C8Tx; LQFP-48_7x7mm_P0.5mm; Manufacturer_Part_Number STM32F302C8T6
Y101: 16MHz; ABM816000MHZB2T; Manufacturer_Part_Number ABM8-16.000MHZ-B2-T

Connections:
+3.3V: C101.1, C102.1, C103.1, C104.1, C105.1, C106.1, C107.1, U101.1 (VBAT), U101.9 (VDDA), U101.24 (VDD), U101.36 (VDD), U101.48 (VDD)
BOOT0: R101.2, U101.44 (BOOT0)
CAN_RX: U101.32 (PA11)
CAN_TX: U101.33 (PA12)
DIR: U101.17 (PA7)
ENC_A: U101.10 (PA0)
ENC_B: U101.11 (PA1)
GND: C101.2, C102.2, C103.2, C104.2, C105.2, C106.2, C107.2, C108.2, C109.2, R101.1, R102.2, U101.8 (VSSA), U101.23 (VSS), U101.35 (VSS), U101.47 (VSS), Y101.2, Y101.4
HSE_IN: C108.1, U101.5 (PF0), Y101.1
HSE_OUT: R103.1, TP101.1, U101.6 (PF1)
I2C_SCL: U101.30 (PA9)
I2C_SDA: U101.31 (PA10)
LED_STAT: D101.2 (A), U101.41 (PB5)
NRST: U101.7 (NRST)
unnamed: D101.1 (K), R102.1
PWM: U101.16 (PA6)
SRAM_SPI_MIS0: U101.27 (PB14)
SRAM_SPI_MOSI: U101.28 (PB15)
SRAM_SPI_SCK: U101.26 (PB13)
SRAM_~CS: U101.25 (PB12)
SRAM_~HOLD: U101.29 (PA8)
SW_LIMIT: U101.19 (PB1)
SYS_JTCK-SWCLK: U101.37 (PA14)
SYS_JTDO-TRACESWO: U101.39 (PB3)
SYS_JTMS-SWDIO: U101.34 (PA13)
XTAL_OUT: C109.1, R103.2, Y101.3
~FLT: U101.14 (PA4)
~SLP: U101.15 (PA5)

Notes on the sheet:
Motor Controller
Rough Estimate (10% of calculated value) 1/(2*pi*F*C_{L2}) = 1/(2*pi*16MHz*27pF) = 368.41 368.41 * 0.1 = 36.841
1: Bootloader 0: Run from flash
!!! TODO !!! RCC_CR_HSERDY is unstable please review schematic to find problem
HSE Resonator
TODO consider adding inductor for low pass here
CPU Decoupling Capacitors
STM32 Ref. AN4206 (Fig. 4)
STM32 Crystal Ref. AN2867
(100)
C = (2*CL) - (2*Cstray) CL = 18pF Cstray = 5pF C = 26pF ~= 27pF
ABM8-16.000MHZ-B2-T
