Silversmithe/motor-controller-modules/single_quad_rt_hp/hardware/motor_controller/motor_driver.kicad_sch

## KiCad design single_quad_rt_hp/hardware/motor_controller/motor_driver.kicad_sch (2023-04-17)

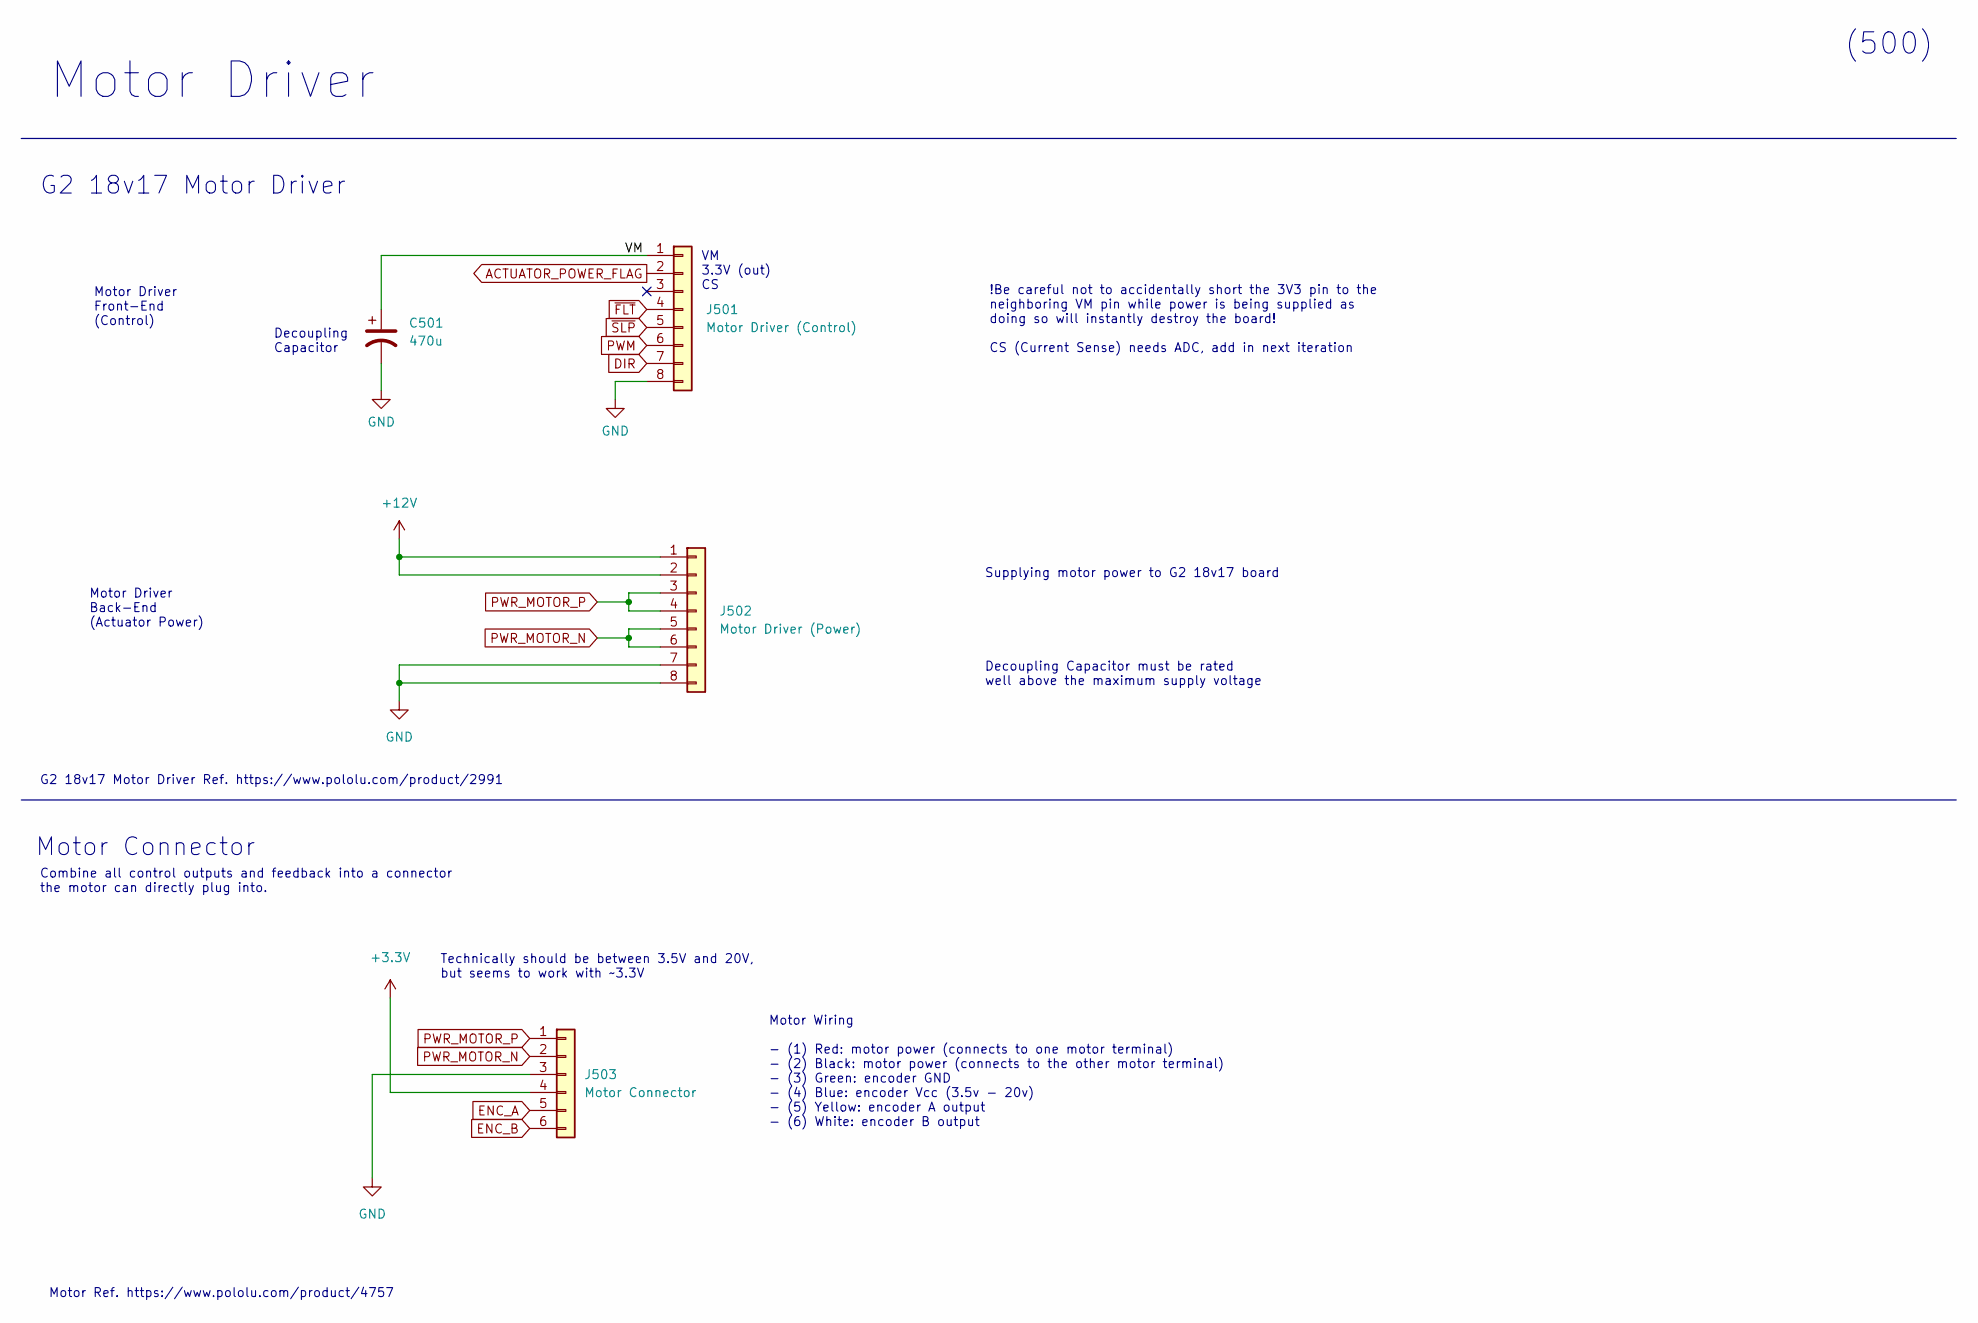
[picture p23: schematic motor_driver.kicad_sch]

Parts:
C501: 470u; CP_Radial_D8.0mm_P3.50mm
J501: Motor Driver (Control); PinSocket_1x08_P2.54mm_Vertical
J502: Motor Driver (Power); PinSocket_1x08_P2.54mm_Vertical
J503: Motor Connector; PinHeader_1x06_P2.54mm_Vertical

Connections:
+3.3V: J503.4
+12V: J502.1, J502.2
ACTUATOR_POWER_FLAG: J501.2
DIR: J501.7
ENC_A: J503.5
ENC_B: J503.6
GND: C501.2, J501.8, J502.7, J502.8, J503.3
PWM: J501.6
PWR_MOTOR_N: J502.5, J502.6, J503.2
PWR_MOTOR_P: J502.3, J502.4, J503.1
VM: C501.1, J501.1
~FLT: J501.4
~SLP: J501.5

Notes on the sheet:
Motor Ref. https://www.pololu.com/product/4757
Technically should be between 3.5V and 20V, but seems to work with ~3.3V
!Be careful not to accidentally short the 3V3 pin to the neighboring VM pin while power is being supplied as doing so will instantly destroy the board! CS (Current Sense) needs ADC, add in next iteration
Motor Wiring - (1) Red: motor power (connects to one motor terminal) - (2) Black: motor power (connects to the other motor terminal) - (3) Green: encoder GND - (4) Blue: encoder Vcc (3.5v - 20v) - (5) Yellow: encoder A output - (6) White: encoder B output
VM 3.3V (out) CS
Supplying motor power to G2 18v17 board
Motor Driver
Decoupling Capacitor must be rated well above the maximum supply voltage
Motor Connector
G2 18v17 Motor Driver Ref. https://www.pololu.com/product/2991
(500)
Combine all control outputs and feedback into a connector the motor can directly plug into.
Motor Driver Back-End (Actuator Power)
Decoupling Capacitor
G2 18v17 Motor Driver
Motor Driver Front-End (Control)
