Silversmithe/motor-controller-modules/single_quad_rt_hp/hardware/motor_controller/peripherals.kicad_sch

## KiCad design single_quad_rt_hp/hardware/motor_controller/peripherals.kicad_sch (2023-04-17)

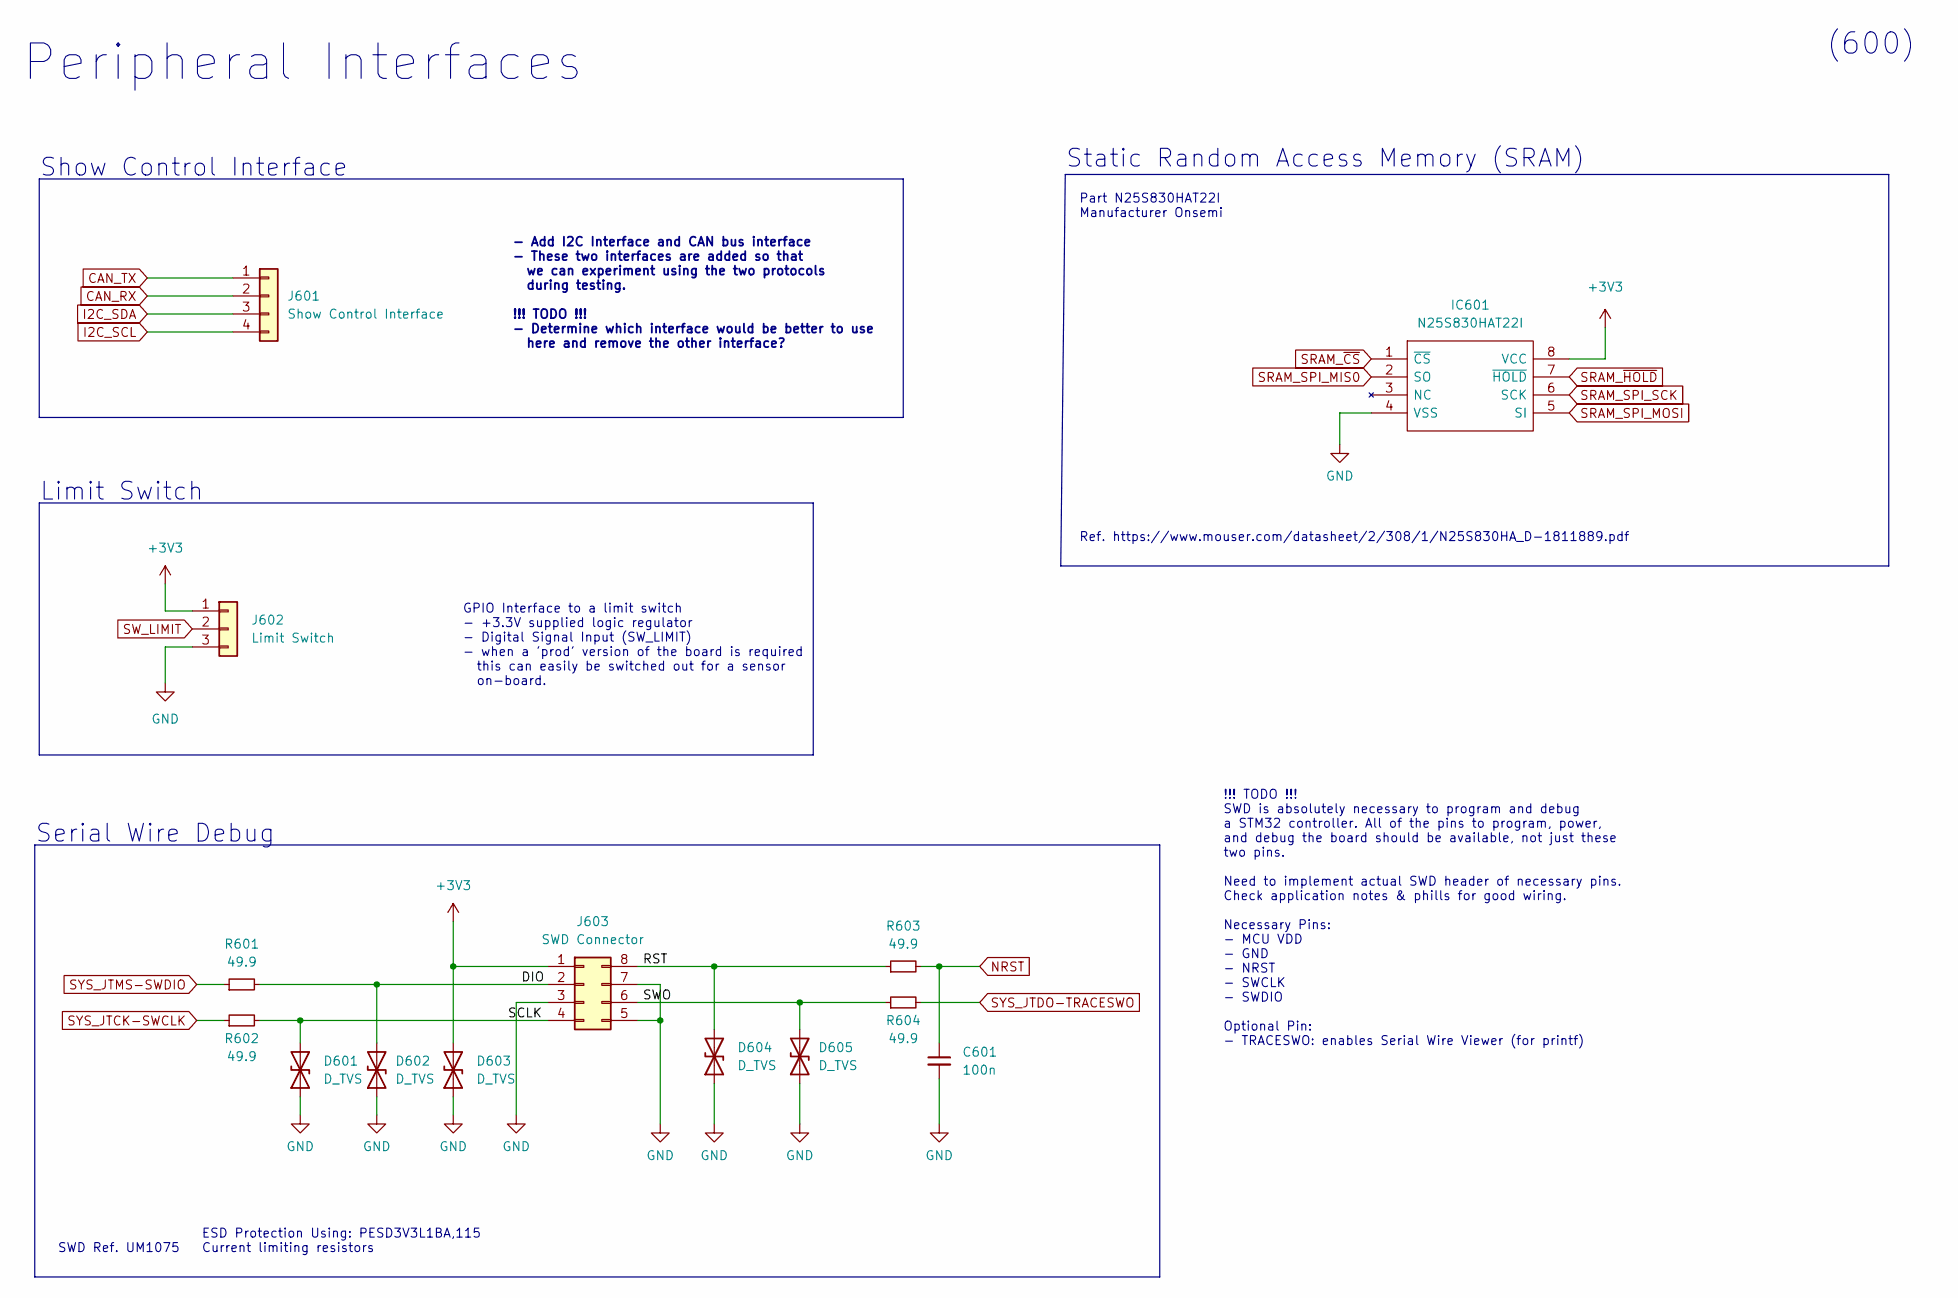
[picture p24: schematic peripherals.kicad_sch]

Parts:
C601: 100n; R_0402_1005Metric; Manufacturer_Part_Number CC0402KRX7R9BB104
D601, D602, D603, D604, D605: D_TVS; SOD2512X110N; Manufacturer_Part_Number PESD3V3L1BA,115
IC601: N25S830HAT22I; SOP65P640X120-8N; Mouser Part Number 863-N25S830HAT22I
J601: Show Control Interface; PinSocket_1x04_P2.54mm_Vertical
J602: Limit Switch; PinSocket_1x03_P2.54mm_Vertical
J603: SWD Connector; PinHeader_2x04_P2.54mm_Vertical
R601, R602, R603, R604: 49.9; R_0402_1005Metric; Manufacturer_Part_Number 0402WGF499JTCE

Connections:
+3V3: D603.2 (A2), IC601.8 (VCC), J602.1, J603.1
CAN_RX: J601.2
CAN_TX: J601.1
DIO: D602.2 (A2), J603.2, R601.2
GND: C601.2, D601.1 (A1), D602.1 (A1), D603.1 (A1), D604.1 (A1), D605.1 (A1), IC601.4 (VSS), J602.3, J603.3, J603.5, J603.7
I2C_SCL: J601.4
I2C_SDA: J601.3
NRST: C601.1, R603.2
RST: D604.2 (A2), J603.8, R603.1
SCLK: D601.2 (A2), J603.4, R602.2
SRAM_SPI_MIS0: IC601.2 (SO)
SRAM_SPI_MOSI: IC601.5 (SI)
SRAM_SPI_SCK: IC601.6 (SCK)
SRAM_~CS: IC601.1 (~CS)
SRAM_~HOLD: IC601.7 (~HOLD)
SWO: D605.2 (A2), J603.6, R604.1
SW_LIMIT: J602.2
SYS_JTCK-SWCLK: R602.1
SYS_JTDO-TRACESWO: R604.2
SYS_JTMS-SWDIO: R601.1

Notes on the sheet:
Limit Switch
Static Random Access Memory (SRAM)
- Add I2C Interface and CAN bus interface - These two interfaces are added so that we can experiment using the two protocols during testing. !!! TODO !!! - Determine which interface would be better to use here and remove the other interface?
Ref. https://www.mouser.com/datasheet/2/308/1/N25S830HA_D-1811889.pdf
!!! TODO !!! SWD is absolutely necessary to program and debug a STM32 controller. All of the pins to program, power, and debug the board should be available, not just these two pins. Need to implement actual SWD header of necessary pins. Check application notes & phills for good wiring. Necessary P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
Part N25S830HAT22I Manufacturer Onsemi
ESD Protection Using: PESD3V3L1BA,115 Current limiting resistors
Serial Wire Debug
SWD Ref. UM1075
Show Control Interface
GPIO Interface to a limit switch - +3.3V supplied logic regulator - Digital Signal Input (SW_LIMIT) - when a 'prod' version of the board is required this can easily be switched out for a sensor on-board.
Peripheral Interfaces
(600)
