Silversmithe/motor-controller-modules/single_quad_rt_hp/hardware/motor_controller/power.kicad_sch

## KiCad design single_quad_rt_hp/hardware/motor_controller/power.kicad_sch (2023-04-17)

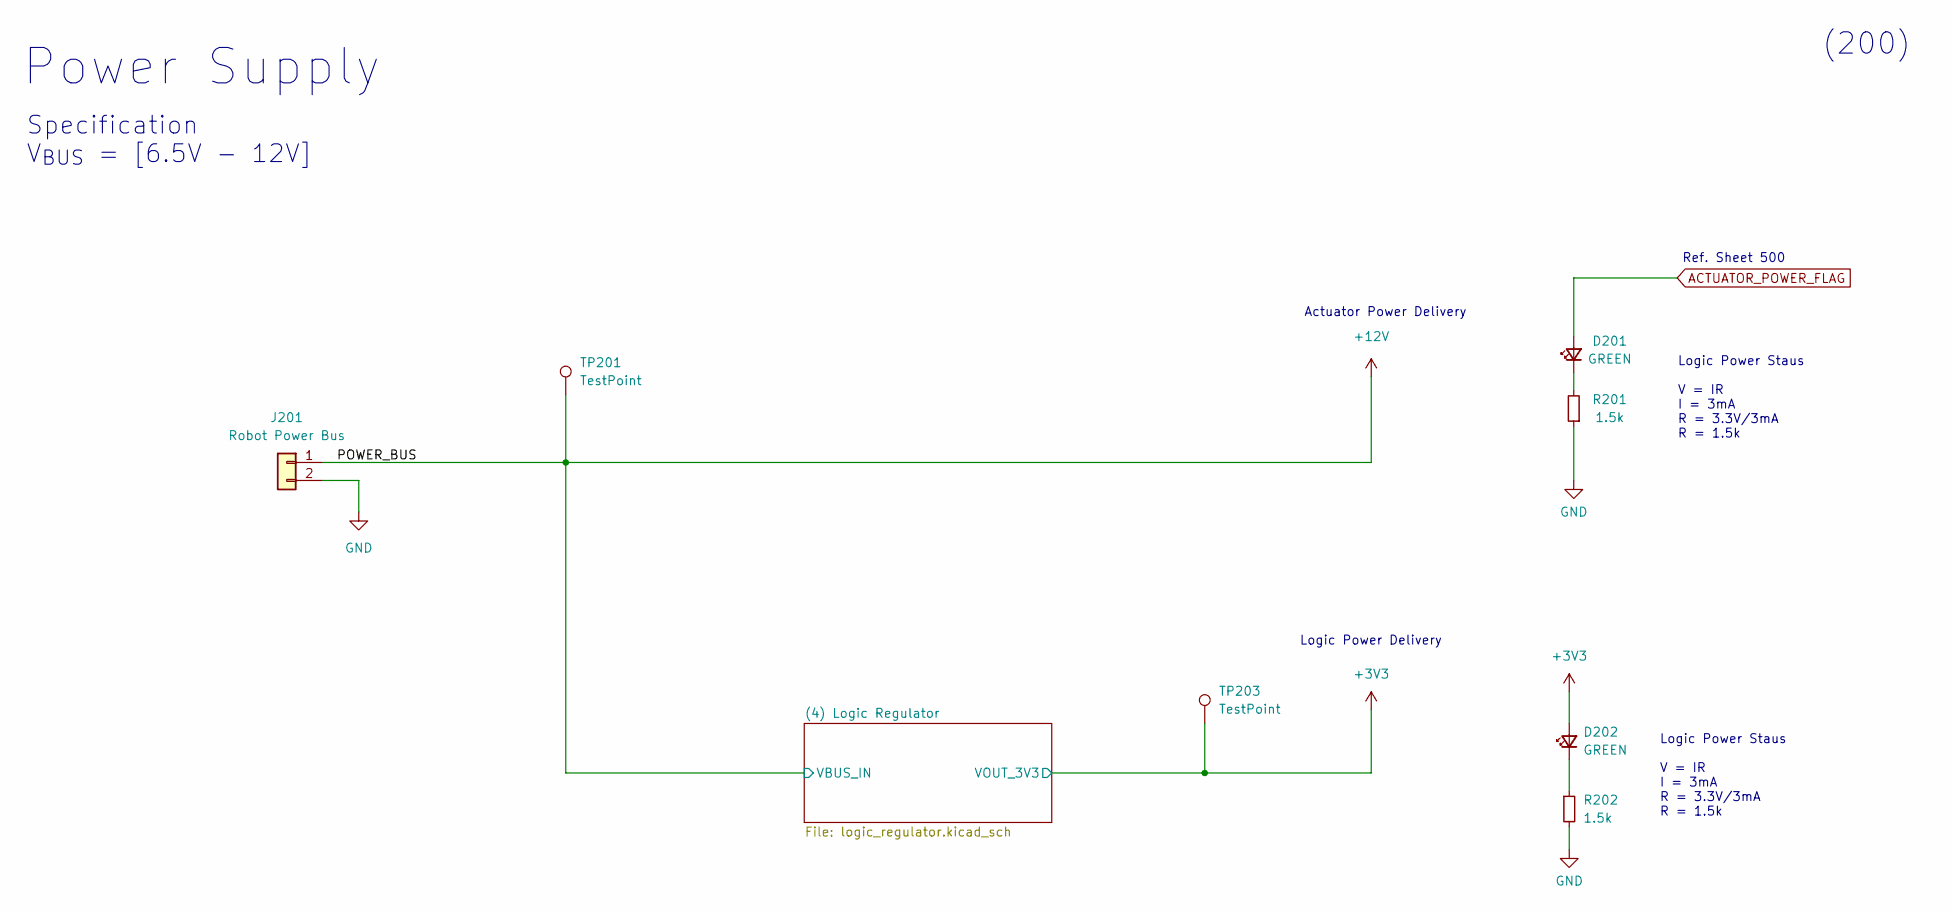
[picture p25: schematic power.kicad_sch]

Parts:
D201, D202: GREEN; LED_0603_1608Metric; Manufacturer_Part_Number 19-217/GHC-YR1S2/3T
J201: Robot Power Bus; PinSocket_1x02_P2.54mm_Vertical
R201, R202: 1.5k; R_0603_1608Metric; Manufacturer_Part_Number 0603WAF1501T5E
TP201, TP203: TestPoint; TestPoint_Pad_1.5x1.5mm

Connections:
+3V3: D202.2 (A), TP203.1
+12V: J201.1, TP201.1
ACTUATOR_POWER_FLAG: D201.2 (A)
GND: J201.2, R201.1, R202.2
unnamed: D201.1 (K), R201.2
unnamed: D202.1 (K), R202.1

Notes on the sheet:
Logic Power Delivery
Specification V_{BUS} = [6.5V - 12V]
(200)
Logic Power Staus V = IR I = 3mA R = 3.3V/3mA R = 1.5k
Ref. Sheet 500
Actuator Power Delivery
Power Supply
