Silversmithe/motor-controller-modules/single_quad_rt_hp/bringup/Core/Src/main.c

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
/* Includes ------------------------------------------------------------------*/
#include "main.h"

/* USER CODE BEGIN Includes */
#include "stdbool.h"
/* USER CODE END Includes */

CAN_HandleTypeDef hcan;

I2C_HandleTypeDef hi2c2;

SPI_HandleTypeDef hspi2;

TIM_HandleTypeDef htim2;
TIM_HandleTypeDef htim16;

void SystemClock_Config(void);
static void MX_GPIO_Init(void);
static void MX_CAN_Init(void);
static void MX_I2C2_Init(void);
static void MX_TIM2_Init(void);
static void MX_TIM16_Init(void);
static void MX_SPI2_Init(void);
/**
  * @brief  The application entry point.
  * @retval int
  */
int main(void)
{
  /* MCU Configuration--------------------------------------------------------*/

  /* Reset of all peripherals, Initializes the Flash interface and the Systick. */
  HAL_Init();

  /* Configure the system clock */
  SystemClock_Config();

  /* Initialize all configured peripherals */
  MX_GPIO_Init();
  MX_CAN_Init();
  MX_I2C2_Init();
  MX_TIM2_Init();
  MX_TIM16_Init();
  MX_SPI2_Init();
  /* USER CODE BEGIN 2 */
  HAL_TIM_Encoder_Start(&htim2, TIM_CHANNEL_ALL);

  /* USER CODE END 2 */

  /* Infinite loop */
  /* USER CODE BEGIN WHILE */
//  GPIO_PinState limit_state, prev_limit_state;

  // HSE test
  uint32_t hse_is_stable = false;

  // ENCODER TEST

  // I2C TRANSMIT
//  uint32_t encoder_position = 0;
//  uint8_t i2c_buffer[4];

  // MOTOR TESTS
  HAL_GPIO_WritePin(DIR_GPIO_Port, DIR_Pin, GPIO_PIN_SET);
  HAL_GPIO_WritePin(PWM_GPIO_Port, PWM_Pin, GPIO_PIN_SET);
  HAL_GPIO_WritePin(NSLP_GPIO_Port, NSLP_Pin, GPIO_PIN_SET);

  while (1)
  {
    /* USER CODE END WHILE */

    /* USER CODE BEGIN 3 */
	// HSE Stability check
	hse_is_stable = (READ_BIT(RCC->CR, RCC_CR_HSERDY) != 0);
	if (hse_is_stable != 0)
	{
		HAL_GPIO_WritePin(LED_STAT_GPIO_Port, LED_STAT_Pin, GPIO_PIN_RESET);
	}
	{
		HAL_GPIO_WritePin(LED_STAT_GPIO_Port, LED_STAT_Pin, GPIO_PIN_RESET);
		HAL_Delay(200);
		HAL_GPIO_WritePin(LED_STAT_GPIO_Port, LED_STAT_Pin, GPIO_PIN_SET);
		HAL_Delay(200);
	}

	// LED TEST
//	HAL_GPIO_WritePin(LED_STAT_GPIO_Port, LED_STAT_Pin, GPIO_PIN_RESET);
//	HAL_Delay(1000);
//	HAL_GPIO_WritePin(LED_STAT_GPIO_Port, LED_STAT_Pin, GPIO_PIN_SET);
//	HAL_Delay(1000);

	// LIMIT SWITCH TEST
//	prev_limit_state = limit_state;
//	limit_state = HAL_GPIO_ReadPin(SW_LIMIT_GPIO_Port, SW_LIMIT_Pin);
//	HAL_GPIO_WritePin(LED_STAT_GPIO_Port, LED_STAT_Pin, limit_state);
//	HAL_Delay(100);

//	// ENCODER TEST
//	encoder_position = TIM2->CNT;

	// I2C TRANSMIT
//	i2c_buffer[3] = (encoder_position >> 24) & 0xFF;
//	i2c_buffer[2] = (encoder_position >> 16) & 0xFF;
//	i2c_buffer[1] = (encoder_position >> 8) & 0xFF;
//	i2c_buffer[0] = encoder_position & 0xFF;
//	HAL_I2C_Slave_Transmit(&hi2c2, i2c_buffer, 4, HAL_MAX_DELAY);
//	HAL_Delay(100);

	// BASIC MOTOR TEST
//	prev_limit_state = limit_state;
//	limit_state = HAL_GPIO_ReadPin(SW_LIMIT_GPIO_Port, SW_LIMIT_Pin);
//	if (limit_state == GPIO_PIN_SET)
//	{
//		HAL_GPIO_WritePin(PWM_GPIO_Port, PWM_Pin, GPIO_PIN_SET);
//		HAL_GPIO_WritePin(LED_STAT_GPIO_Port, LED_STAT_Pin, GPIO_PIN_SET);
//	}
//	else
//	{
//		HAL_GPIO_WritePin(PWM_GPIO_Port, PWM_Pin, GPIO_PIN_RESET);
//		HAL_GPIO_WritePin(LED_STAT_GPIO_Port, LED_STAT_Pin, GPIO_PIN_RESET);
//	}
  }
  /* USER CODE END 3 */
}

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
/* USER CODE BEGIN 4 */
int _write(int file, char *ptr, int len)
{
  /* Implement your write code here, this is used by puts and printf for example */
  int i=0;
  for(i=0 ; i<len ; i++)
    ITM_SendChar((*ptr++));
  return len;
}

/* USER CODE END 4 */
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
