Silversmithe/motor-controller-modules/single_quad_rt_hp/bringup/Core/Inc/main.h

#define ENC_A_Pin GPIO_PIN_0
#define ENC_A_GPIO_Port GPIOA
#define ENC_B_Pin GPIO_PIN_1
#define ENC_B_GPIO_Port GPIOA
#define NFLT_Pin GPIO_PIN_4
#define NFLT_GPIO_Port GPIOA
#define NSLP_Pin GPIO_PIN_5
#define NSLP_GPIO_Port GPIOA
#define PWM_Pin GPIO_PIN_6
#define PWM_GPIO_Port GPIOA
#define DIR_Pin GPIO_PIN_7
#define DIR_GPIO_Port GPIOA
#define SW_LIMIT_Pin GPIO_PIN_1
#define SW_LIMIT_GPIO_Port GPIOB
#define SRAM_NCS_Pin GPIO_PIN_12
#define SRAM_NCS_GPIO_Port GPIOB
#define SRAM_SPI_SCK_Pin GPIO_PIN_13
#define SRAM_SPI_SCK_GPIO_Port GPIOB
#define SRAM_SPI_MISO_Pin GPIO_PIN_14
#define SRAM_SPI_MISO_GPIO_Port GPIOB
#define SRAM_SPI_MOSI_Pin GPIO_PIN_15
#define SRAM_SPI_MOSI_GPIO_Port GPIOB
#define SRAM_NHOLD_Pin GPIO_PIN_8
#define SRAM_NHOLD_GPIO_Port GPIOA
#define LED_STAT_Pin GPIO_PIN_5
#define LED_STAT_GPIO_Port GPIOB
