Silversmithe/motor-controller-modules/(commit log)

2023-01-30 Added motor controller project from jibo hw here
    [BOM-motor_controller.csv, actuator_regulator.kicad_sch, bus_regulator.kicad_sch, logic_regulator.kicad_sch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]
2023-01-30 Moving bringup firmware into the same project
    [BOM-motor_controller.csv, actuator_regulator.kicad_sch, bringup Debug.cfg, bus_regulator.kicad_sch, logic_regulator.kicad_sch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]
2023-04-17 [single_quad_rt_hp] removing switching regs and simplifying the sceme
    [logic_regulator.kicad_sch, motor_controller.kicad_pcb, motor_controller.kicad_sch, motor_driver.kicad_sch, peripherals.kicad_sch, power.kicad_sch, requirements.kicad_sch]
