Silversmithe/motor-controller-modules/(notices)

Notices in the files:
single_quad_rt_hp/bringup/Core/Src/main.c:
Copyright (c) 2022 STMicroelectronics.
All rights reserved.
This software is licensed under terms that can be found in the LICENSE file
